Taro-Hayashi/Pop-n-Top/README.md

# Pop'n Top キーボード ビルドガイド（[English](https://github.com/Taro-Hayashi/Pop-n-Top/blob/main/README_EN.md)）
- [キット内容](#キット内容)
- [組み立て方（はんだ付け）](#組み立て方はんだ付け)
- [動作テスト](#動作テスト)
- [組み立て方（後半）](#組み立て方後半)
- [カスタマイズ](#キーマップの確認変更方法)
- [その他](#その他)

## キット内容
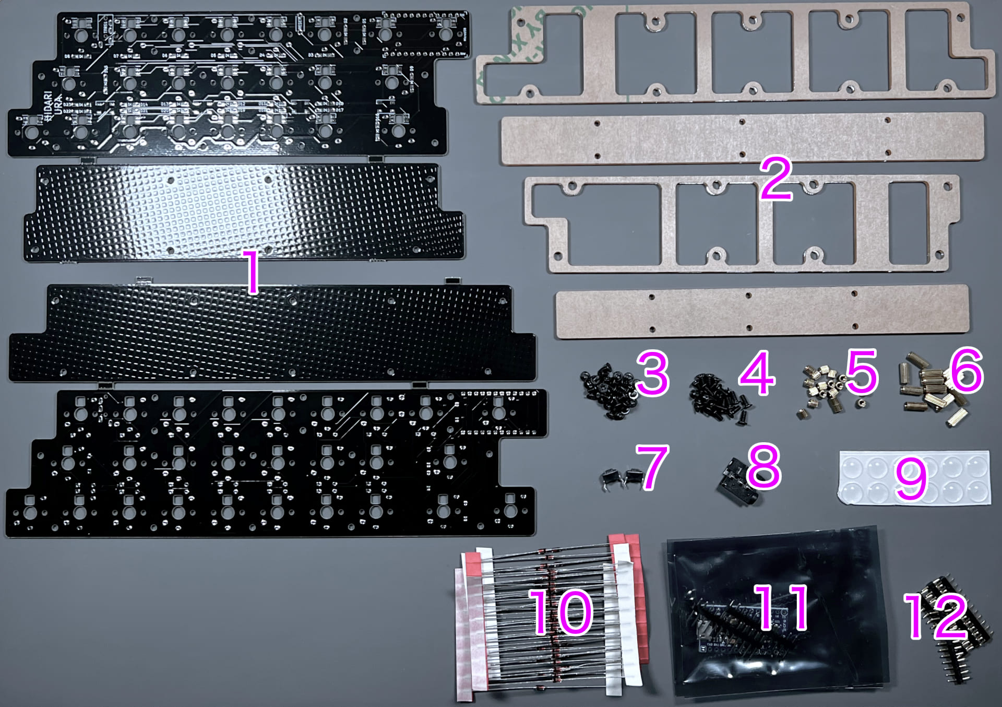
[picture p1: img/IMG_3636.jpg]
  
||部品名|数| |
|-|-|-|-|
|1|メインボード|2||
|1|アクリルプレート|4||
|3|ネジ（短）|36|3mm|
|4|ネジ（長）|24|5mm|
|5|スペーサー（短）|18|3mm|
|6|スペーサー（長）|12|9mm|
|7|リセットスイッチ|2||
|8|TRRSジャック|2||
|9|ゴム足|12||
|10|ダイオード|50||
|11|Pro Micro|2||
|12|コンスルー|4||

## キット以外に必要なもの

リンクにはアフィリエイトリンクを含みます。

|部品名|数||
|-|-|-|
|キースイッチ|50|[Kailh choc V1](https://shop.yushakobo.jp/collections/choc-v1)、Kailh Choc V2（[遊舎工房](https://shop.yushakobo.jp/collections/choc-v2)、[TALPKEYBOARD](https://shop.talpkeyboard.com/collections/keyswitch?ref=tarohayashi)）|
|キーキャップ|50|[選び方](howtochosekeycaps.md)|
|TRRSケーブル|1||
|Micro-USB ケーブル|1||
 - [Pro Micro互換品とコンスルーの対応表](promicro.md)  
 
### LED（[取り付け方](led.md)）
|部品名|数||
|-|-|-|
|[SK6812MINI-E](https://shop.yushakobo.jp/products/sk6812mini-e-10)|50|バックライト|
|[WS2812B](https://shop.yushakobo.jp/products/a0800ws-01-10)|9|アンダーグロー|

### Cintiq Pro用インチネジケース、机上用ケース
https://tarohayashi.booth.pm/items/3154435

## 必要な工具
|工具名|
|-|
|はんだごて|
|こて先クリーナー（こて台）|
|鉛入りはんだ|
|精密ドライバー|
|カッター|
|棒ヤスリ|
|ニッパー等ダイオードの足を切れるもの|
|Microsoft Edge、もしくはGoogle Chrome|

## 準備
メインボードはつながった状態で梱包されています。カッターナイフで軽く切れ込みを入れて曲げるように割ります。  
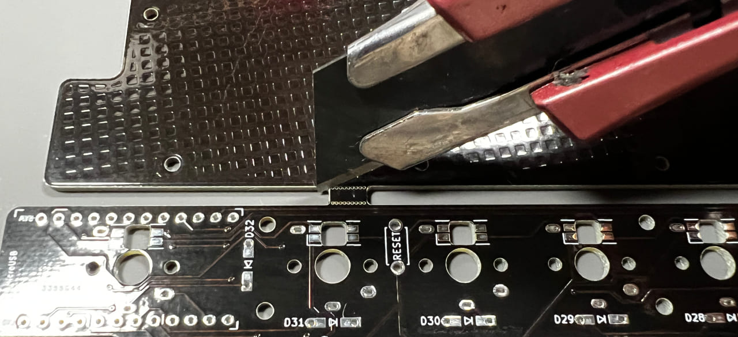
[picture p2: img/IMG_3646.jpg]
  
棒やすりで跡をきれいにします。  
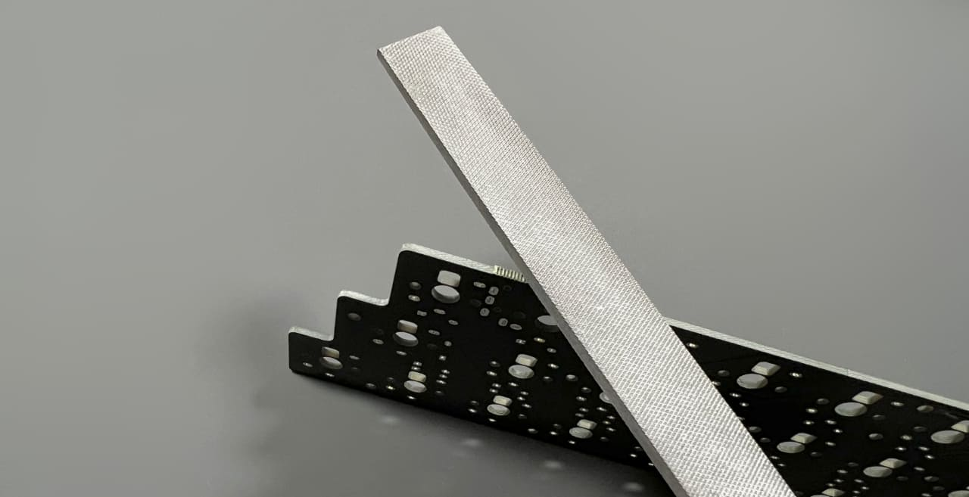
[picture p3: img/IMG_3655.jpg]
 
赤丸の箇所にやすりがけが必要です。
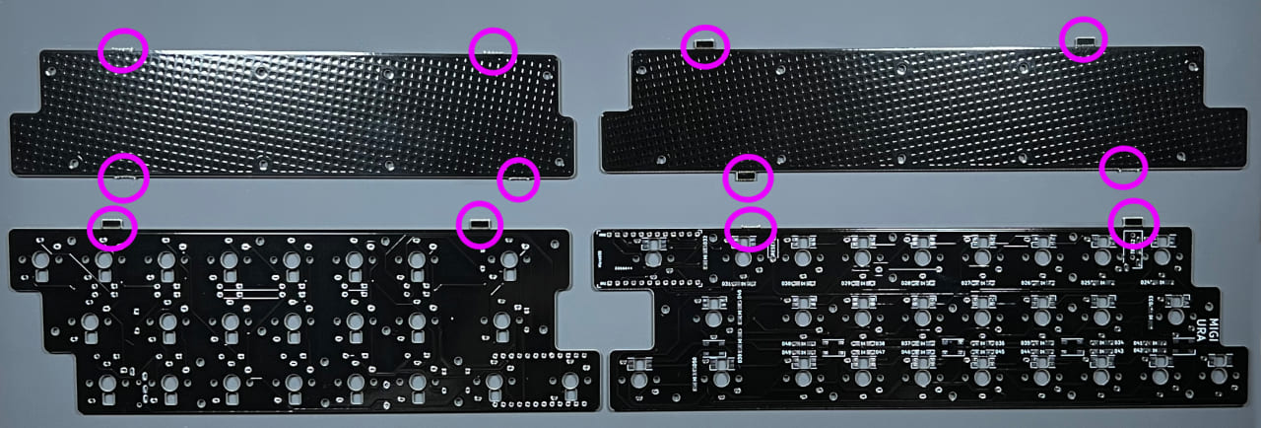
[picture p4: img/IMG_3649.jpg]
 

## 組み立て方（はんだ付け）

ダイオードを取り付けます。  
足を曲げて裏から差し込みます。  
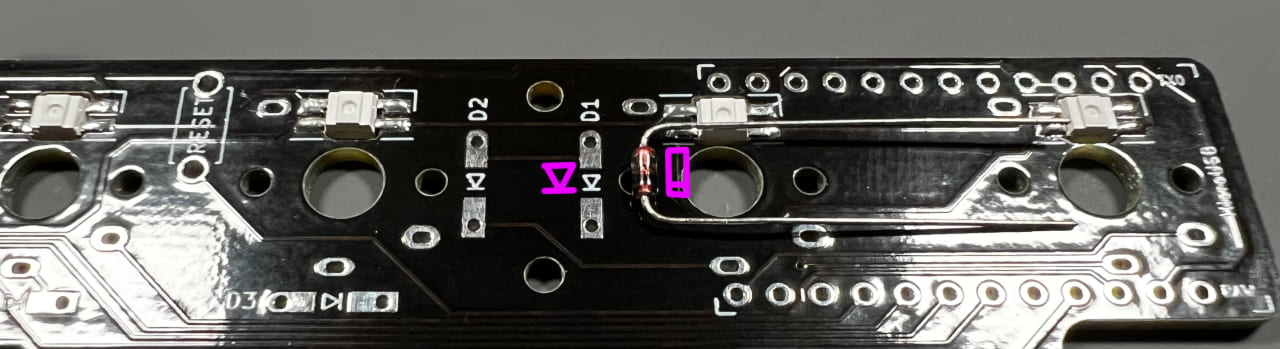
[picture p5: img/IMG_3668.jpg]
  
ダイオードには向きがあります。三角形の先の棒と黒線を合わせましょう。  

表で更に足を曲げて抜けないようにします。  
ダイオードと並行に曲げるとあとでキースイッチに干渉しにくいです。  
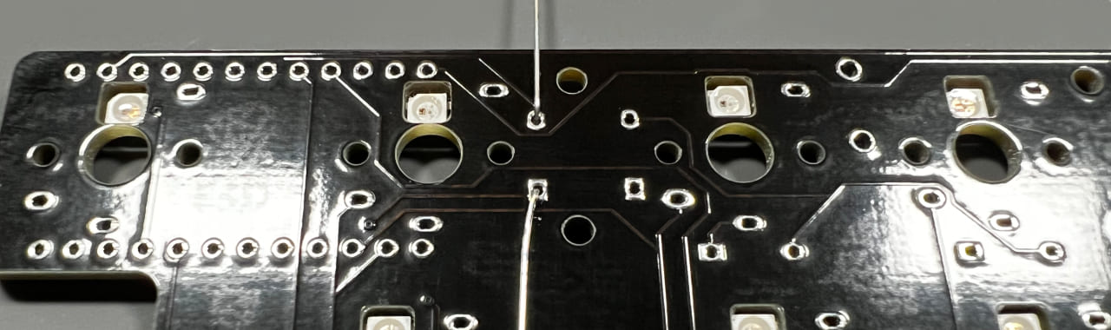
[picture p6: img/IMG_3678.jpg]
   

はんだ付けをして足を切ります。  
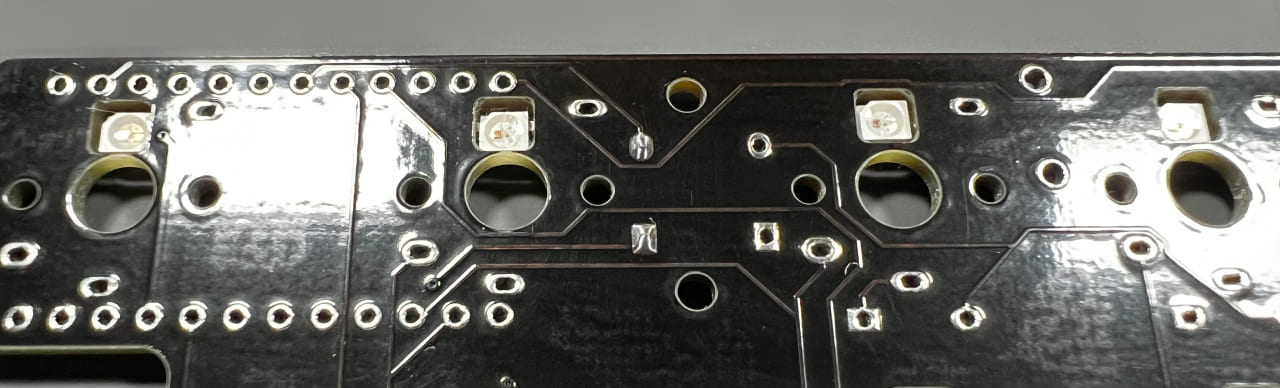
[picture p7: img/IMG_3680.jpg]
  

TRRSジャックを裏から差し込み表ではんだ付けします。 
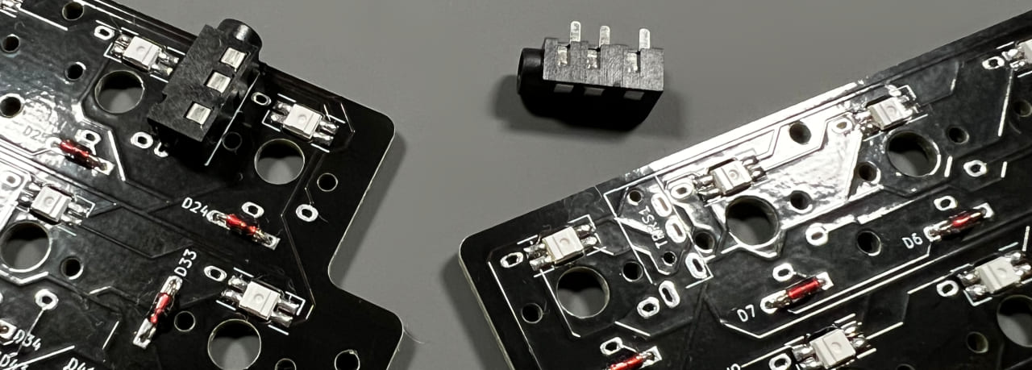
[picture p8: img/IMG_3685.jpg]
  
終わったらリセットスイッチを裏から差し込み表ではんだ付けします。   
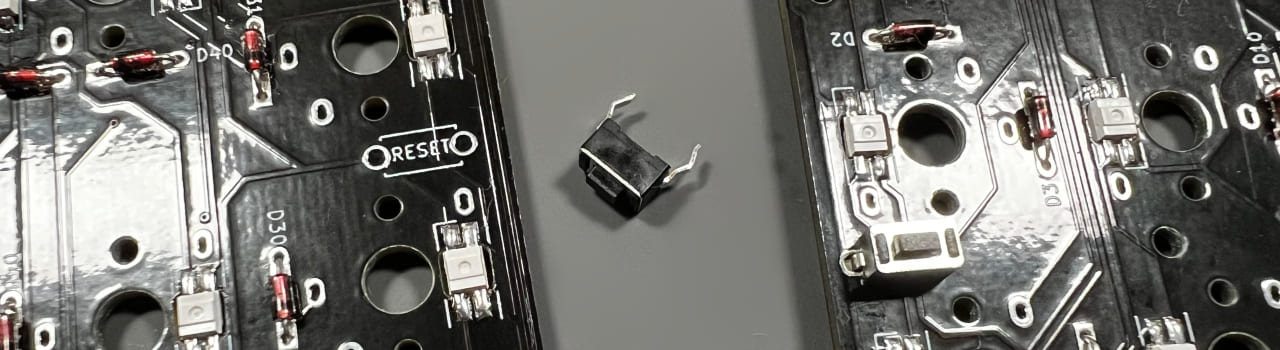
[picture p9: img/IMG_3688.jpg]
  

キースイッチを表から差し込み裏ではんだ付けします。  
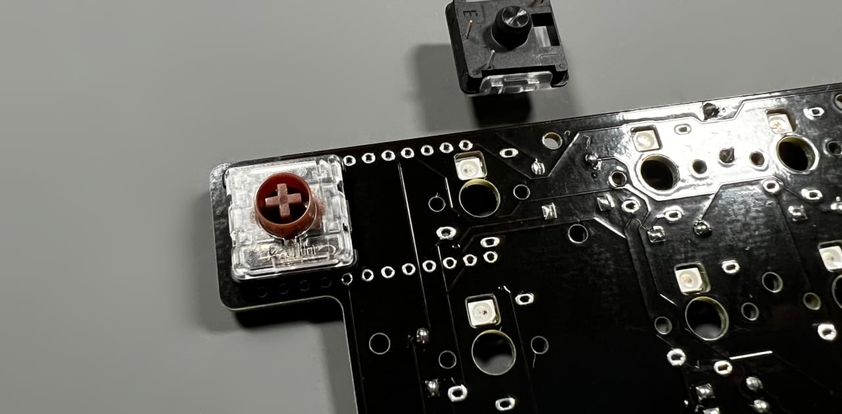
[picture p10: img/IMG_3699.jpg]
  

メインボードの裏にコンスルーを挿します。  
コンスルーの窓が高くて両方とも同じ向きになるように設置します。  
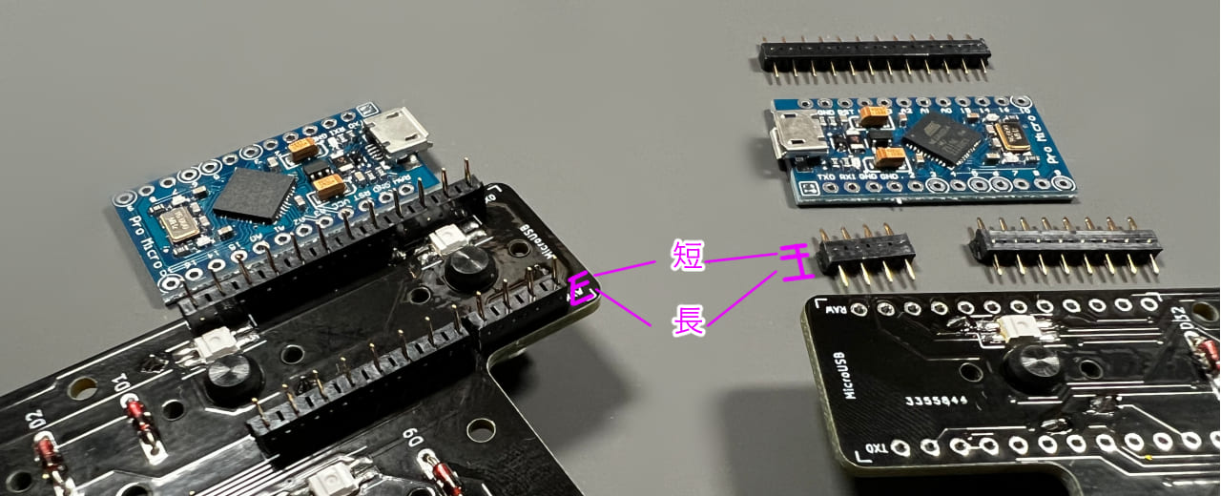
[picture p11: img/IMG_3706.jpg]
   
挿すだけではんだ付けはしません。  

コンスルーにPro Microを挿します。TX0, RAW, USBの位置をシルク印刷と合わせましょう。  
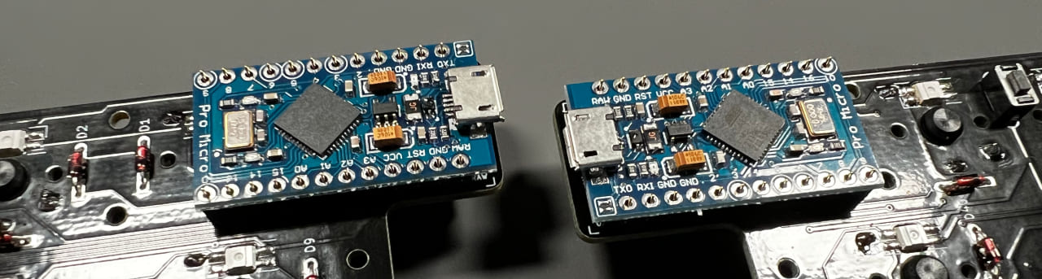
[picture p12: img/IMG_3721.jpg]
  
そして、Pro Micro側のコンスルーの足を半田付けします。  
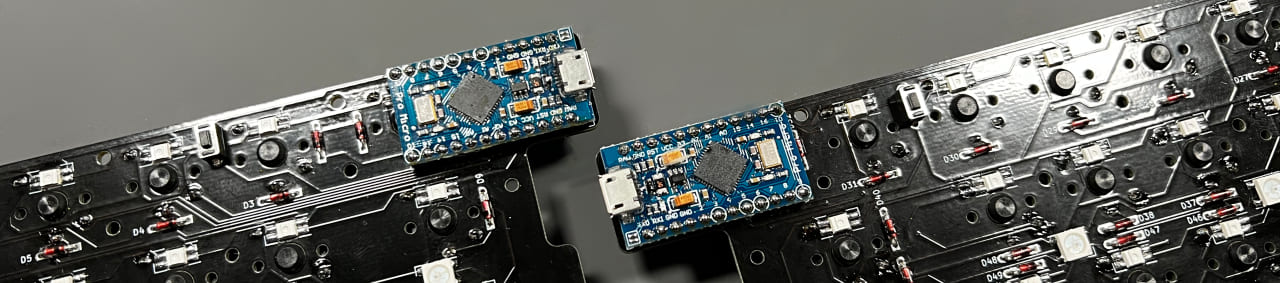
[picture p13: img/IMG_3727.jpg]
  
これでPro Microを抜き差しできるようになりました。  
両手分作り終えたら次に進んでください。  

## 動作テスト
Pro Microに動作ソフト（ファームウェア）を書き込んで動作確認をしましょう。  
キットとPCをUSBケーブルでつないでください。   

下のwebサイトにアクセスしてください。
- https://remap-keys.app/catalog/HJaX1fzuC9SmEQEK3czS/firmware

テストファームウェアを選んでFLASHします。
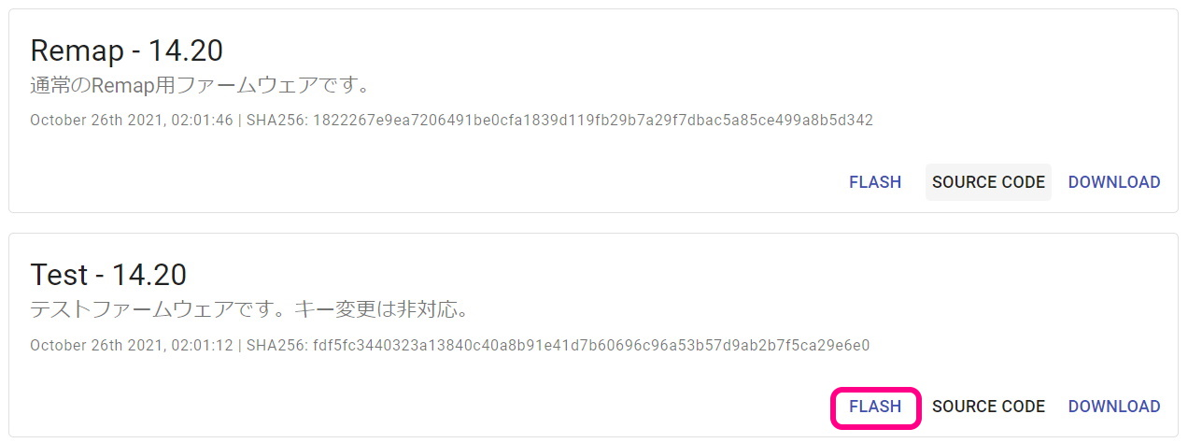
[picture p14: img/remap02.jpg]
  
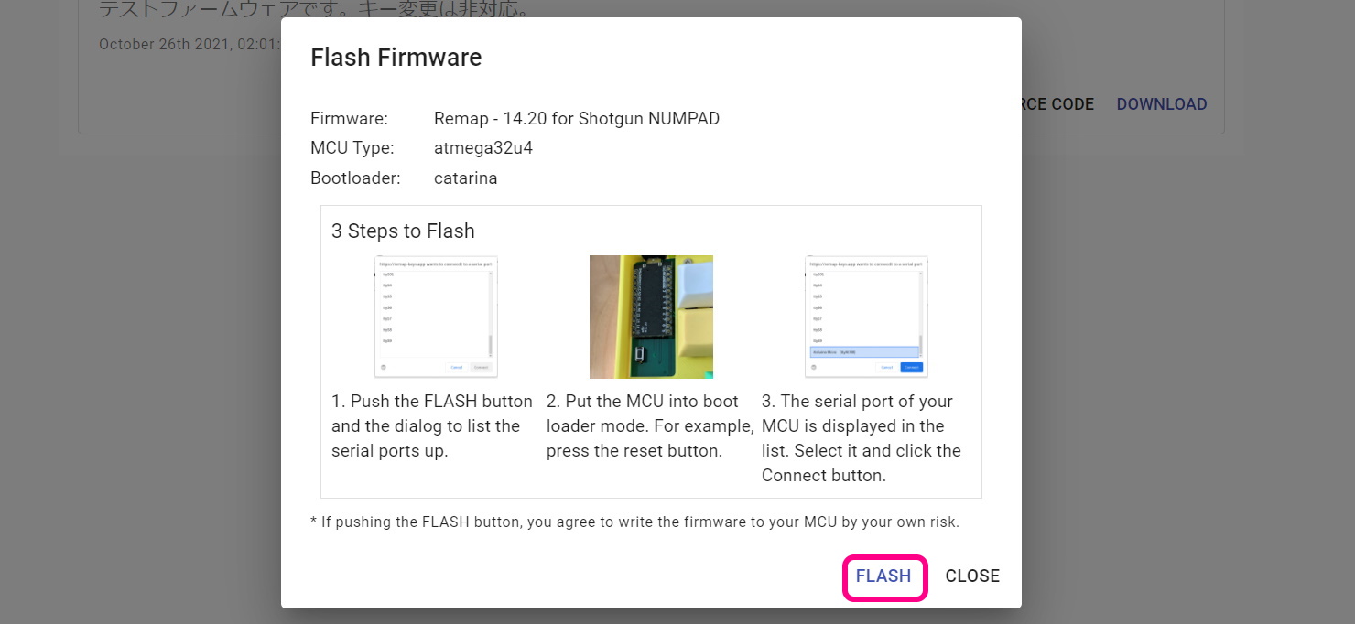
[picture p15: img/remap03.jpg]
  

キットのリセットスイッチを押すとArduino Microが現れるので、クリックして接続します。
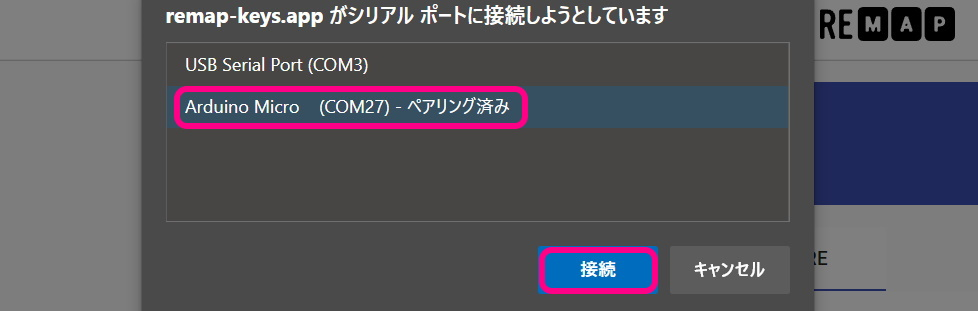
[picture p16: img/remap04.jpg]
 

書き込みが完了したらウィンドウを閉じて大丈夫です。
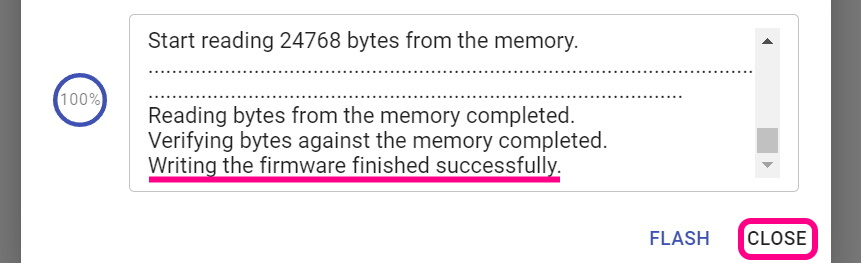
[picture p17: img/remap05.jpg]
 

USBで接続しないと書き込めないので分割キーボードでは左手用と右手用に同じ手順を繰り返します。  
右手用にも同じファームウェアを書き込んでください。  

書き込めたら一度USBケーブルを外し、TRRSケーブルで左右を繋げます。  
（TRRSケーブルを抜き差しするときはPCとは接続しない方が安全だそうです。）  
左手用とPCをUSBケーブルで接続してタイプすると1-50の数字が打てるはずです。     

お疲れ様でした。問題がなければはんだ付けは終了です。  

## 組み立て方（後半）
USBケーブル、TRRSケーブルを抜いてプレートを組付けます。  
アクリルからは保護フィルムを剥がしてください。割れやすいので気をつけましょう。  

メインボード裏面の赤丸の箇所にスペーサー（短）をネジ（短）で取り付けてミドルプレートを嵌めます。  
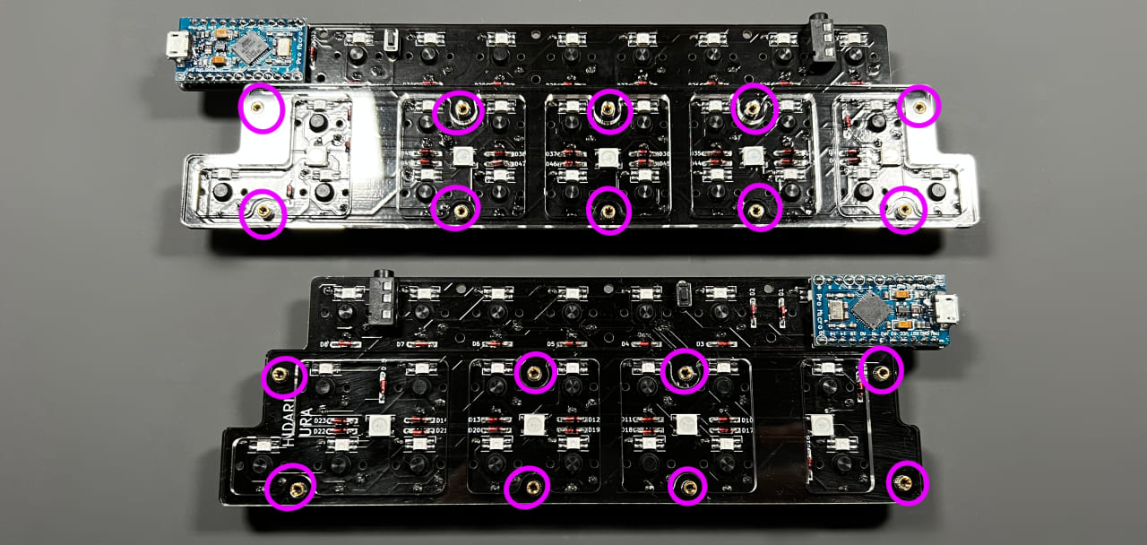
[picture p18: img/IMG_3736.jpg]
  
ボトムプレートをネジ（短）で止めます。  

メインボードの残ったネジ穴にスペーサー（長）をネジ（長）で取り付け、ボトムプレートをネジ（長）で止めます。  
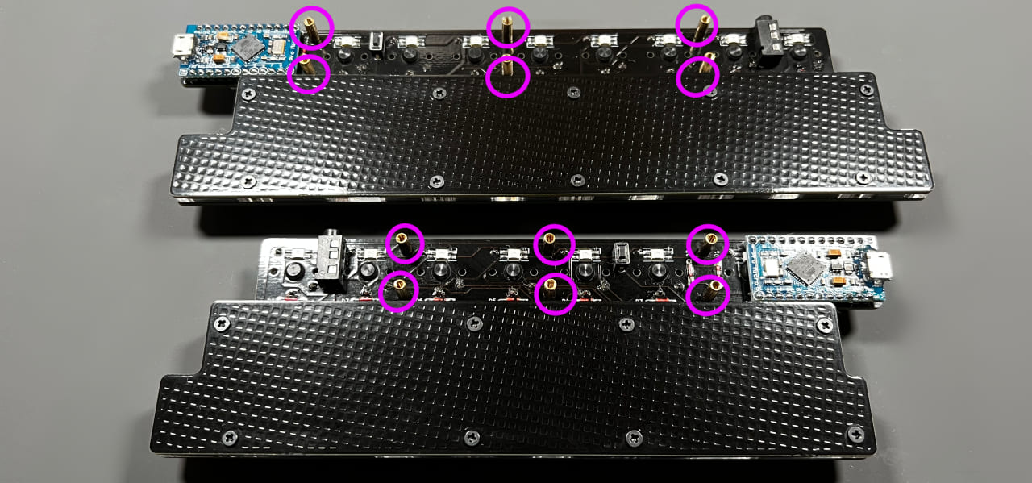
[picture p19: img/IMG_3741.jpg]
   

キーキャップを取り付けたら先ほどと同様の手順で本番用のファームウェアに更新しましょう。
- https://remap-keys.app/catalog/HJaX1fzuC9SmEQEK3czS/firmware
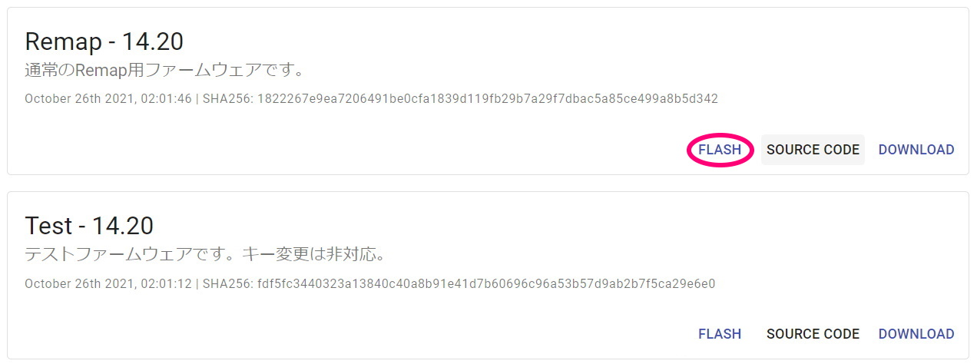
[picture p20: img/remap06.jpg]
  

ゴム足を貼ってTRRSケーブルで左右を繋いだら完成です。  
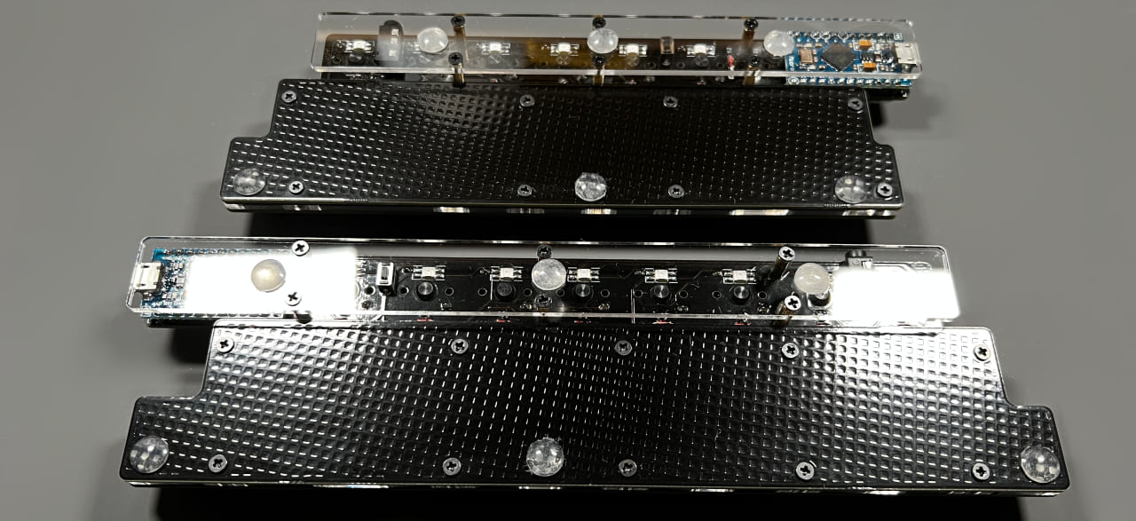
[picture p21: img/IMG_3748.jpg]
  
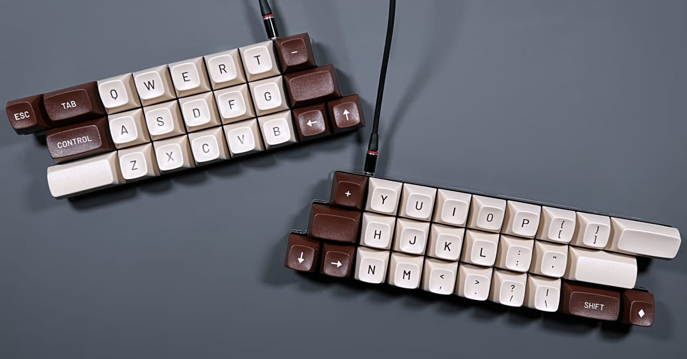
[picture p22: img/IMG_3757.jpg]
  
USBケーブルは左手用に接続してください。  

## キーマップの確認、変更方法
このキットはレイヤー機能を使っています。  
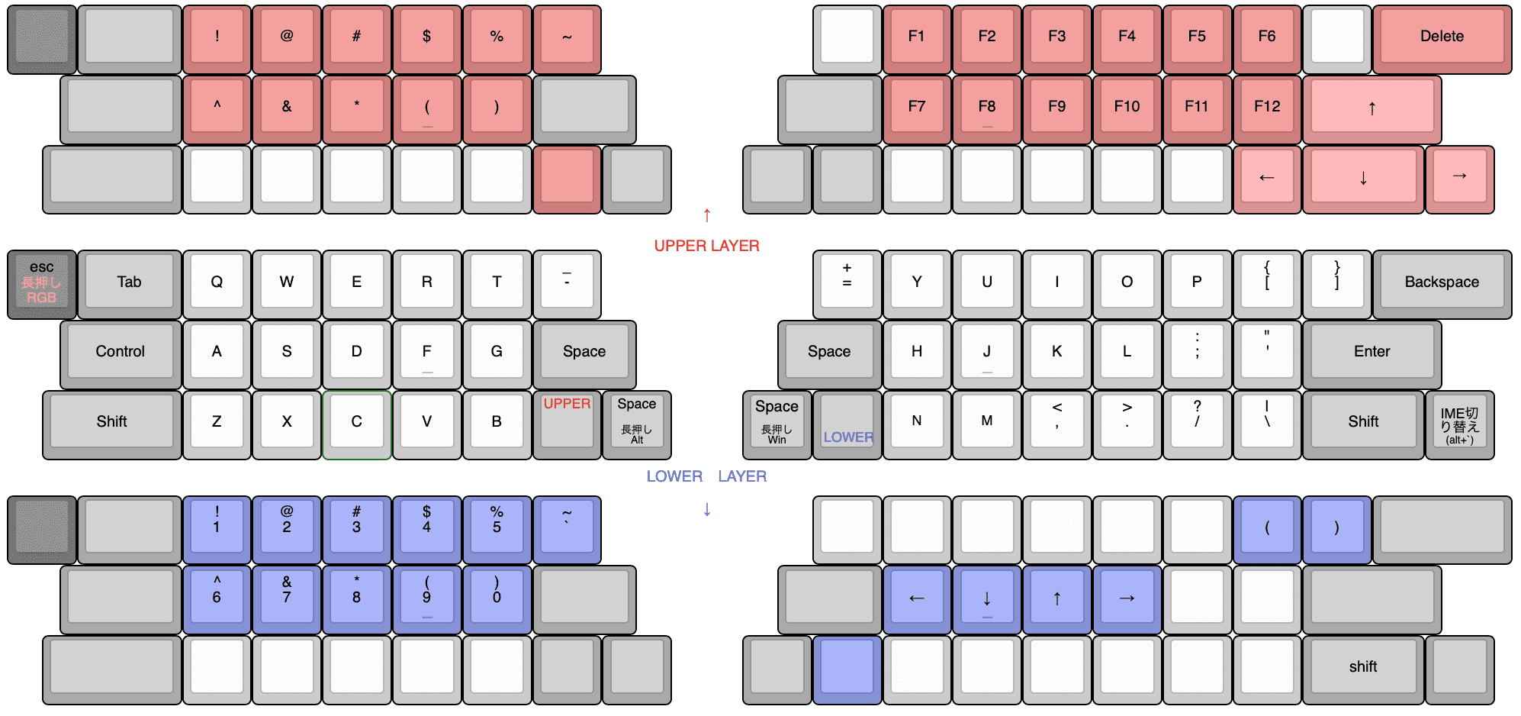
[picture p23: img/layout.png]

[Keyboard Layout Editor で見る](http://www.keyboard-layout-editor.com/#/gists/a78d9342dd93a60fed1b255a5a018bf9)  

使わないキーを削除したり使用頻度の高いキーを押しやすい位置に変更してみましょう。  

  ChromeかEdgeでRemapにアクセスしてください。  
- Remap https://remap-keys.app

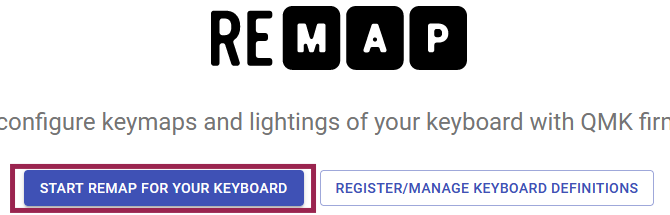
[picture p24: img/remap1.png]
  
左を選んで進んでいくとアドレスバーからメッセージが出てキーボードを選択できます。

キーマップをドラッグアンドドロップで変更し右上のflashボタンを押すと反映されます。  
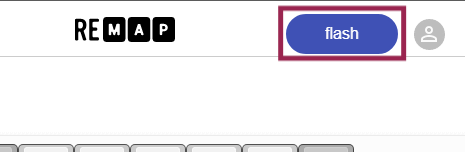
[picture p25: img/remap3.png]
  

## その他
### 液晶タブレットに乗せる
1番上の行を引っ掛ける事で液タブに乗せる事ができます。  
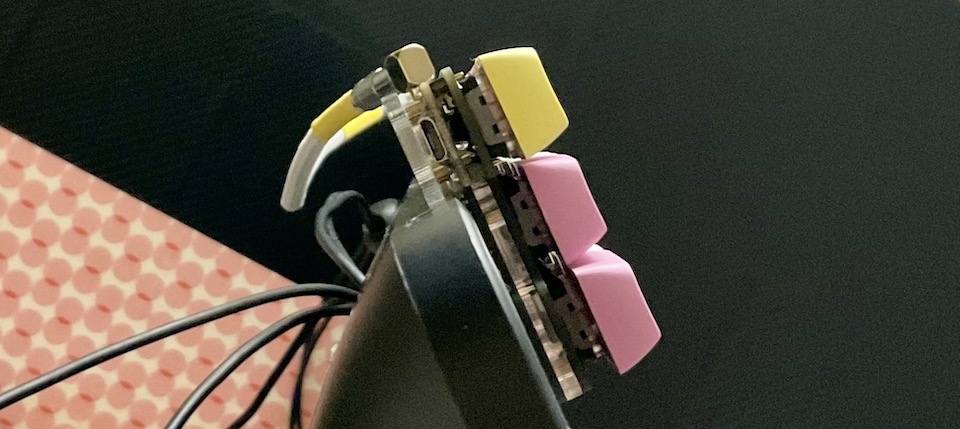
[picture p26: img/tab.jpeg]
  
ゴム足を外して両面テープで固定すると安定します。  
跡が残るといけないので画面には保護フィルムを貼ってください。  
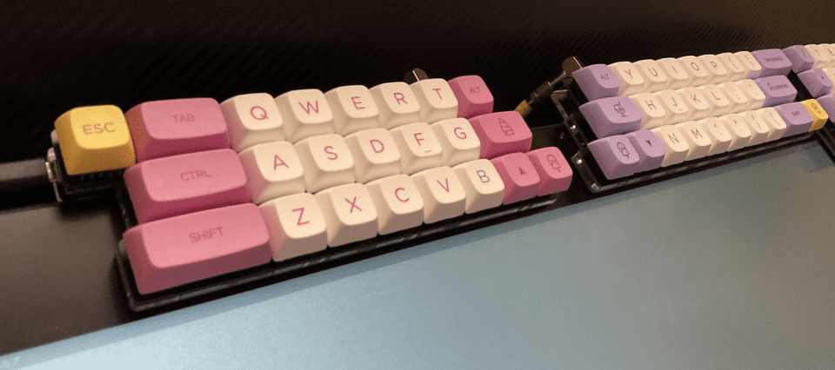
[picture p27: img/popntop.png]


### 色違いアクリルプレート
遊舎工房さんで注文可能です。  
- https://shop.yushakobo.jp/collections/services/products/keyboard_acrylic_plate?variant=43890222498023  
  
デザインデータを公開しているのでご自分で発注をかけることも可能です。  
- [popntop_plates.zip](https://github.com/Taro-Hayashi/Pop-n-Top/releases/download/14.20/popntop_plates.zip)  
  
### ファームウェアのフォルダ  
- [qmk_firmware](qmk_firmware)
  
### 謝辞
foostan様のフットプリントを流用、改変して使わせていただきました。  
https://github.com/foostan/kbd/  
https://github.com/foostan/kbd/blob/master/LICENSE  

- 遊舎工房: https://shop.yushakobo.jp/products/2796  
- BOOTH: https://tarohayashi.booth.pm/items/3154435
