Taro-Hayashi/Pop-n-Top/case.md

# Pop'n Top Cintiq Pro用インチネジケース、机上用ケースの取り付け方

## Cintiq Pro用インチネジケース

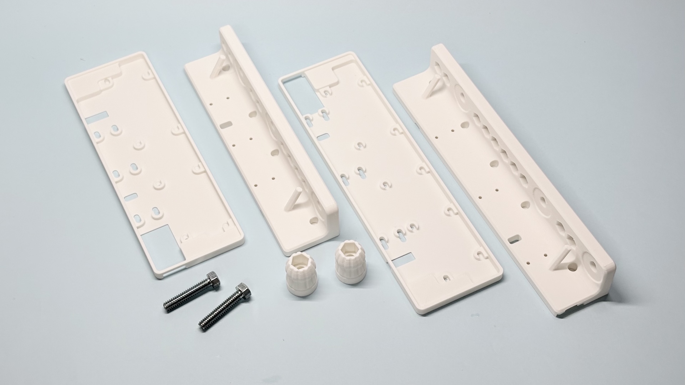
[picture p28: img/case/IMG_4292.jpg]

キーボード背面のネジを全て外してアクリルプレート、ボトムプレートを外します。
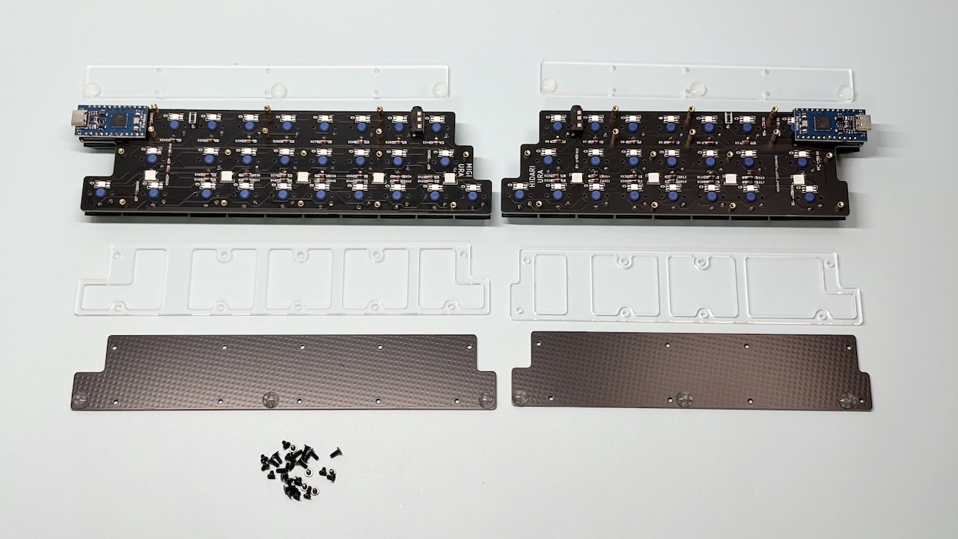
[picture p29: img/case/IMG_4127.jpg]

メインボードをケースに収めます。
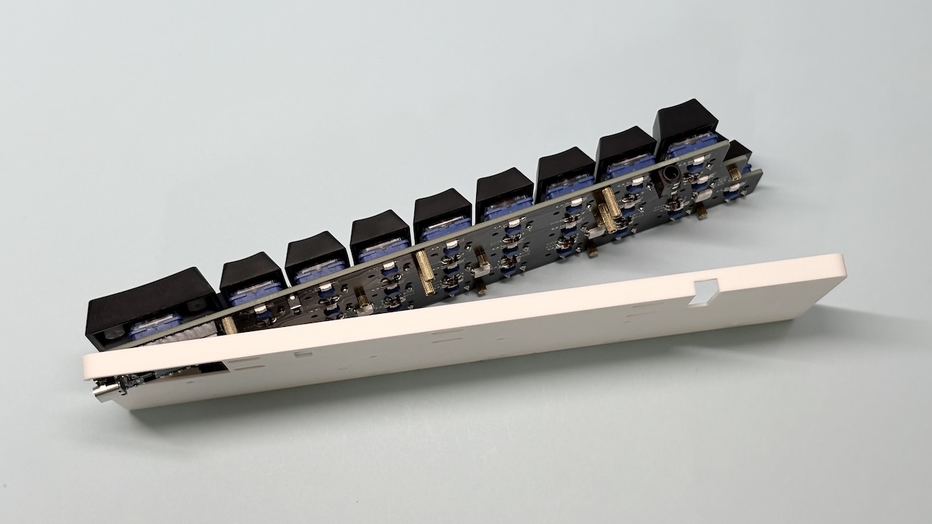
[picture p30: img/case/IMG_4151.jpg]

もとのネジでケースを取り付けます。
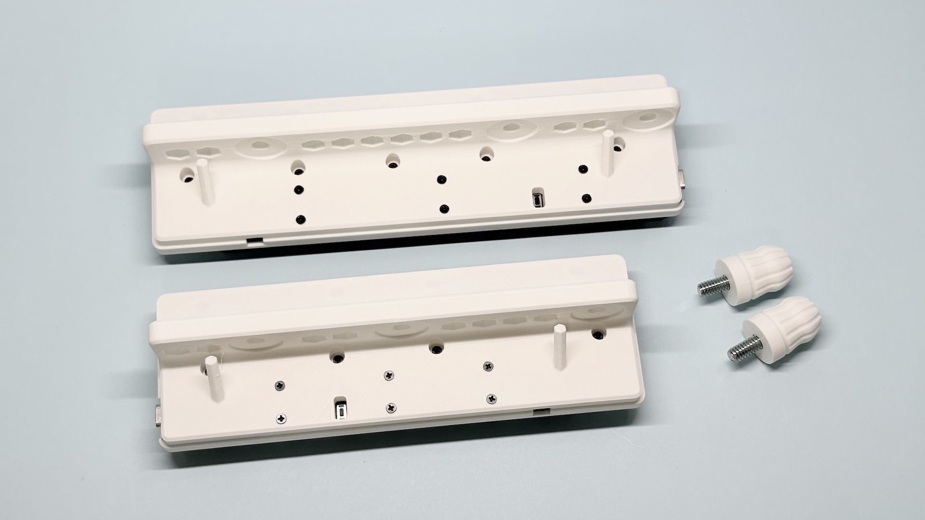
[picture p31: img/case/IMG_4301.jpg]

Cintiq Proに固定します。
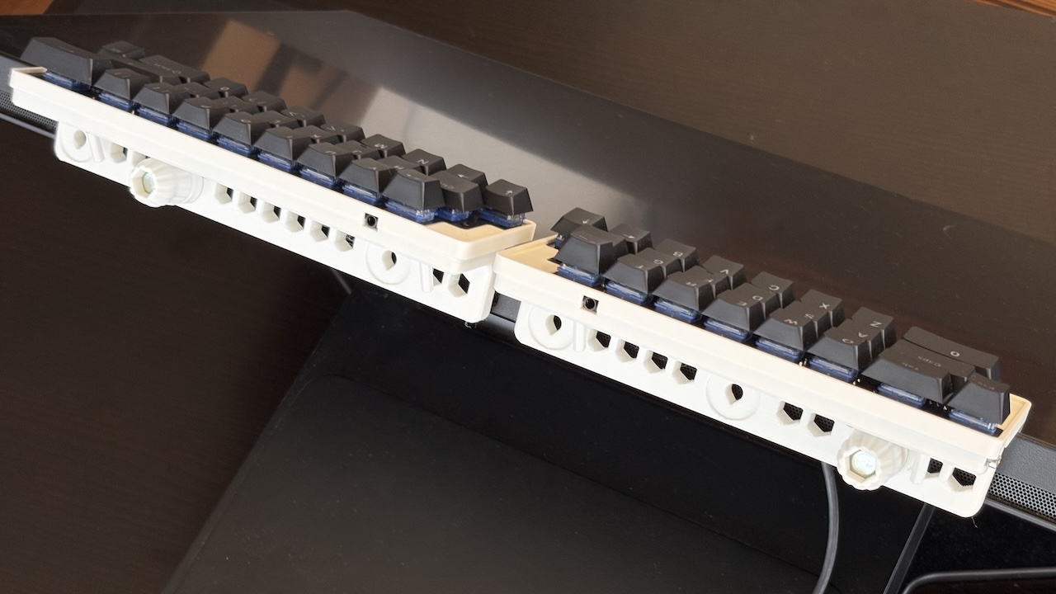
[picture p32: img/case/IMG_4310.jpg]

片手につき3種類取り付け場所があります（Cintiq Pro 22では左右が重なって使えないパターンがあります）。
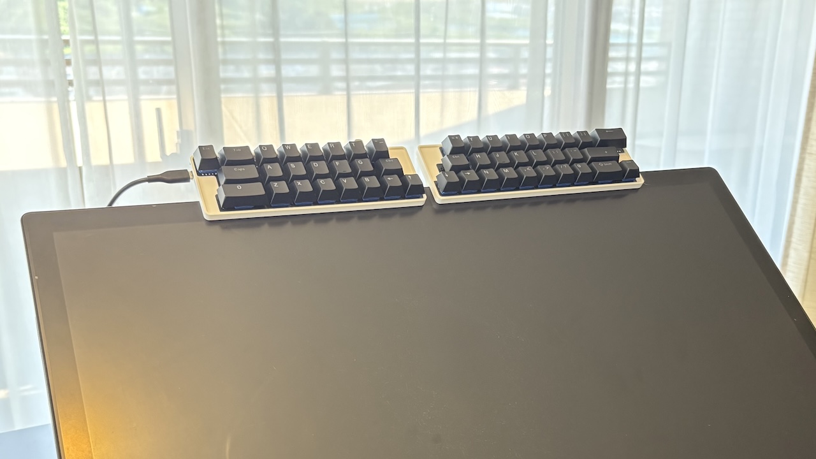
[picture p33: img/case/IMG_4315.jpg]


## 机上用ケース

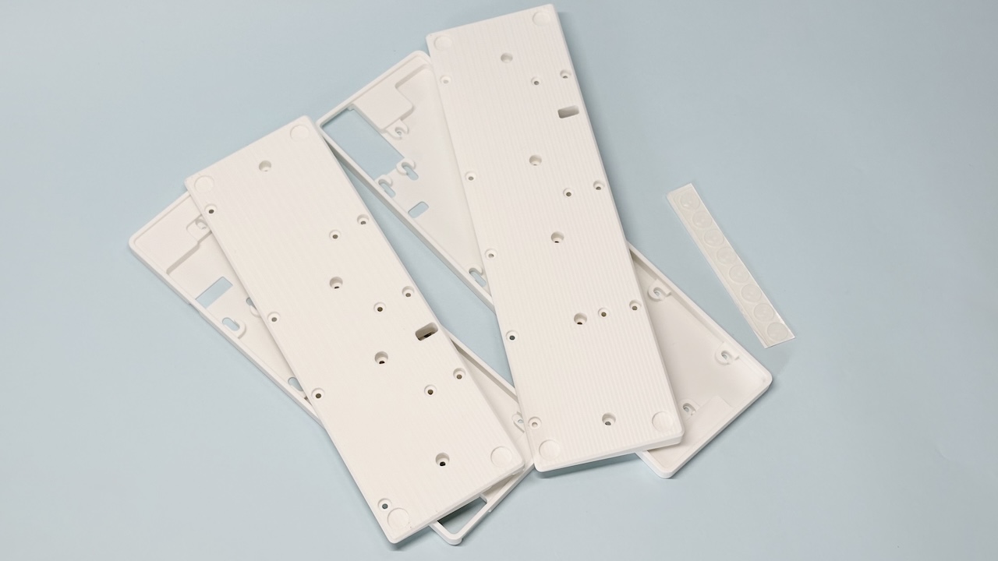
[picture p34: img/case/IMG_4114.jpg]

キーボード背面のネジを全て外してアクリルプレート、ボトムプレートを外します。

メインボードをケースに収めます。

もとのネジでケースを取り付けてゴム足を付けます。
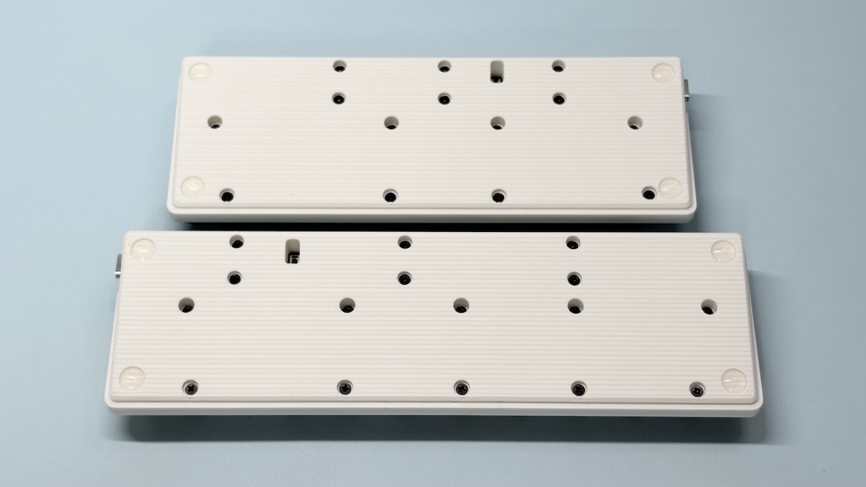
[picture p35: img/case/IMG_4169.jpg]

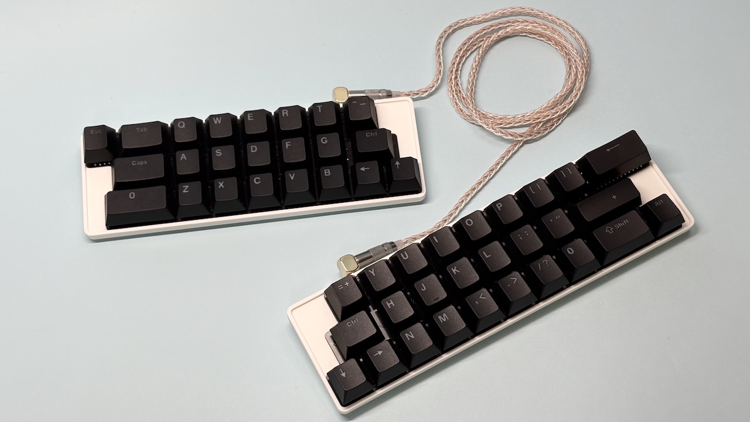
[picture p36: img/case/IMG_4177.jpg]
