Taro-Hayashi/Pop-n-Top/qmk_firmware/keyboards/popntop/README.MD

# Pop'n Top キーボード
- Manual: https://github.com/Taro-Hayashi/Pop-n-Top/blob/main/README_EN.md
- BOOTH: https://tarohayashi.booth.pm/items/3154435
- Yushakobo: https://shop.yushakobo.jp/en/products/2796
