Taro-Hayashi/Pop-n-Top/promicro.md

# Pro Micro互換品とコンスルーの対応表

||付属ピンヘッダ|[2.5mmコンスルー](https://shop.yushakobo.jp/products/31?variant=37665714405537)|[3.5mmコンスルー](https://talpkeyboard.net/items/6229e8c130344b271f290c3c)|
|-|-|-|-|
|Pro Micro|○|○|○|
|Type-C版Pro Micro|○|○|×|
|Elite-C|○|○|○|
