Taro-Hayashi/Pop-n-Top/img/case/IMG_4162.jpg

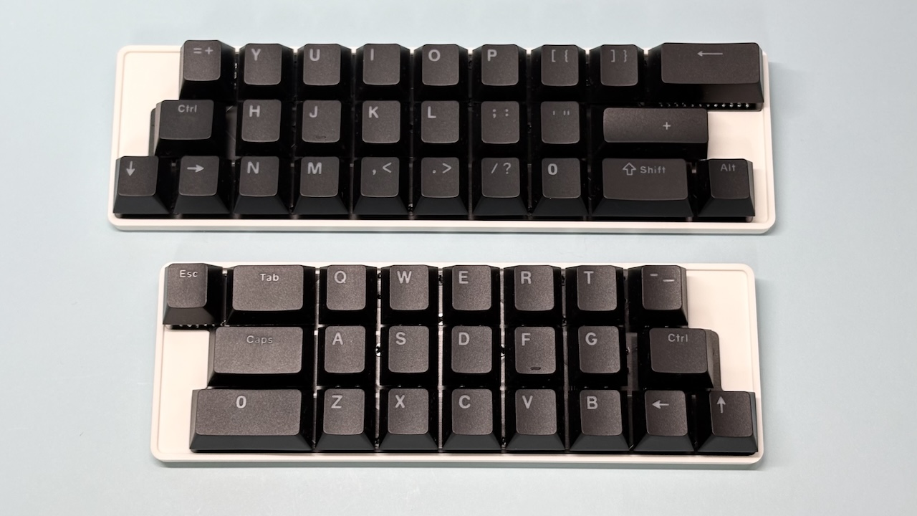
img/case/IMG_4162.jpg
