Taro-Hayashi/Pop-n-Top/img/case/IMG_4438.jpg

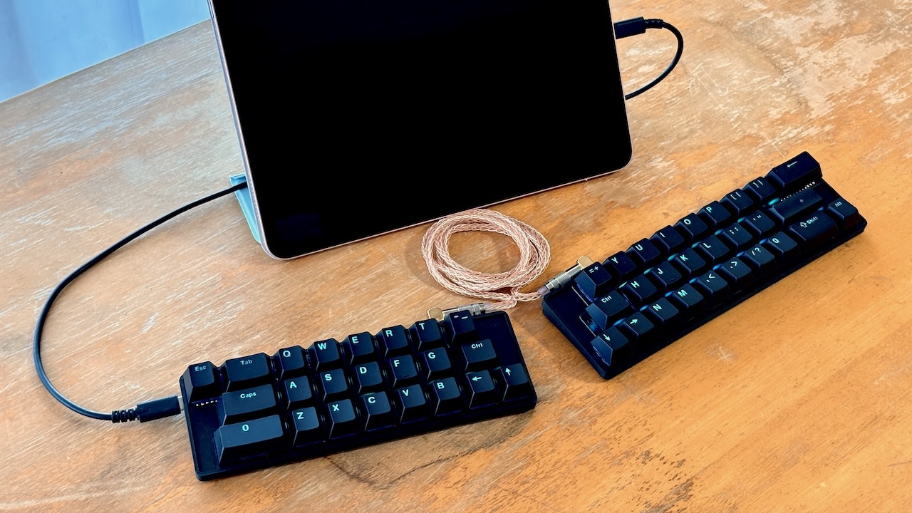
img/case/IMG_4438.jpg
