Taro-Hayashi/Pop-n-Top/img/case/IMG_4446.jpg

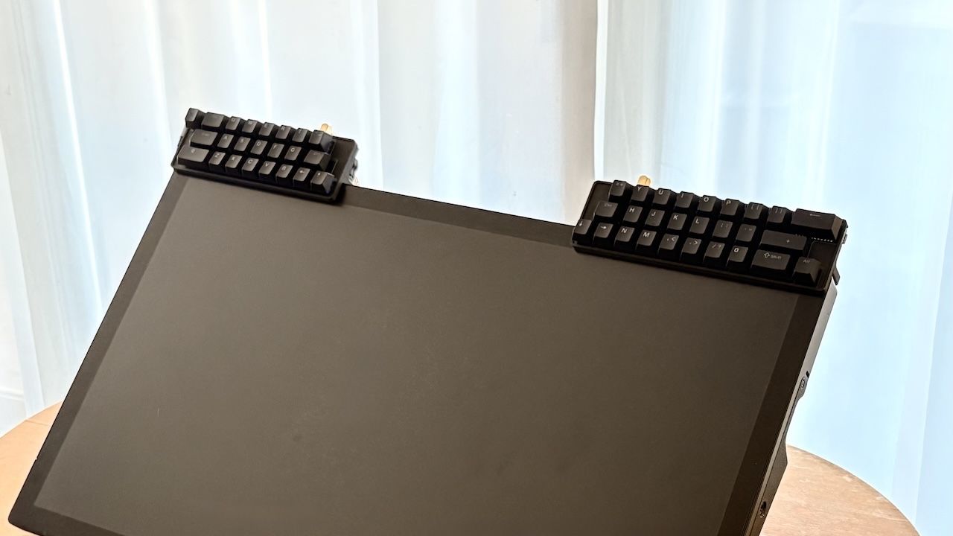
img/case/IMG_4446.jpg
