Taro-Hayashi/Pop-n-Top/img/diode1.jpg

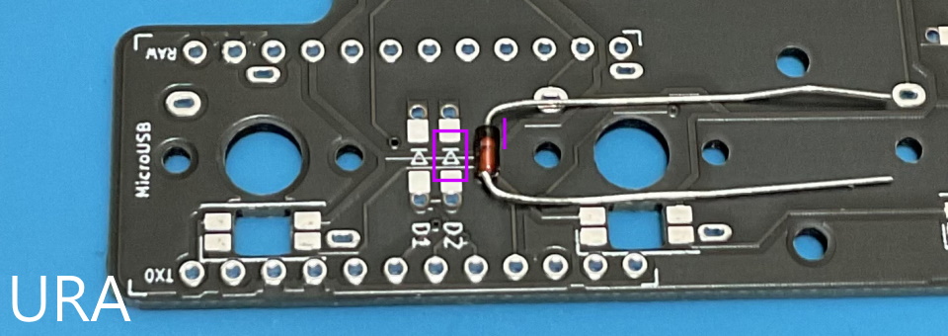
img/diode1.jpg
