Taro-Hayashi/Pop-n-Top/img/diode5.jpg

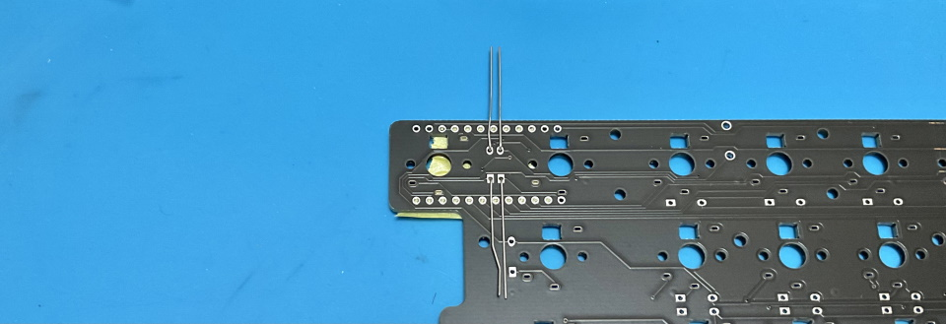
img/diode5.jpg
