Taro-Hayashi/Pop-n-Top/img/diode6.jpg

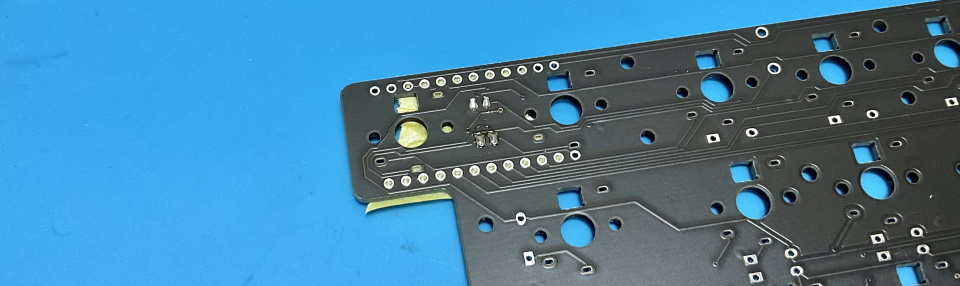
img/diode6.jpg
