Taro-Hayashi/Pop-n-Top/img/full2.jpg

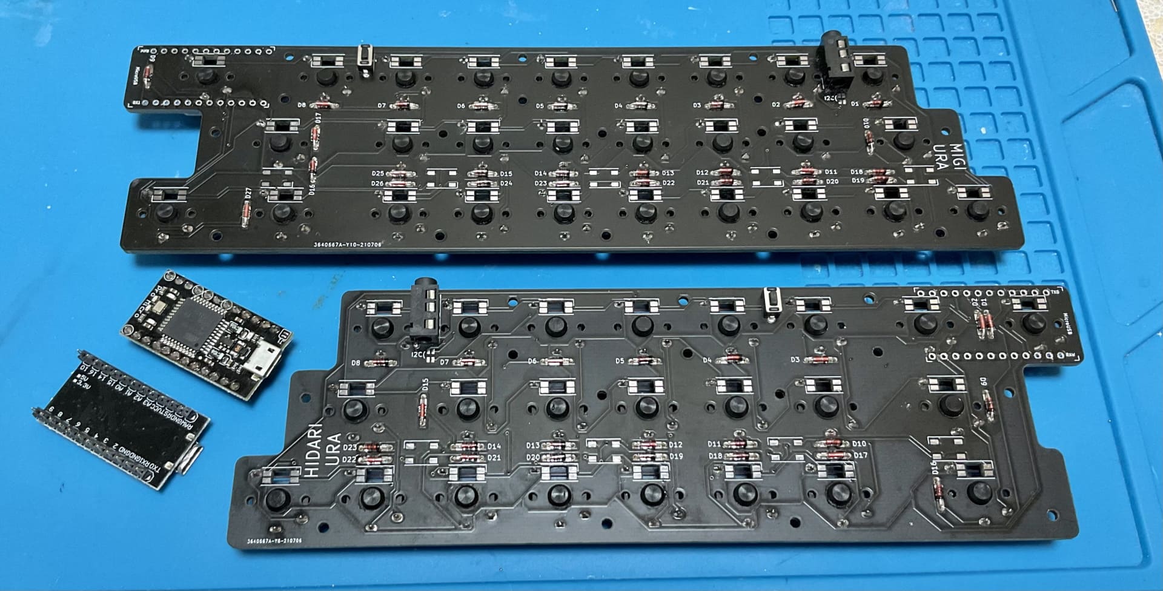
img/full2.jpg
