Taro-Hayashi/Pop-n-Top/img/IMG_4966.jpg

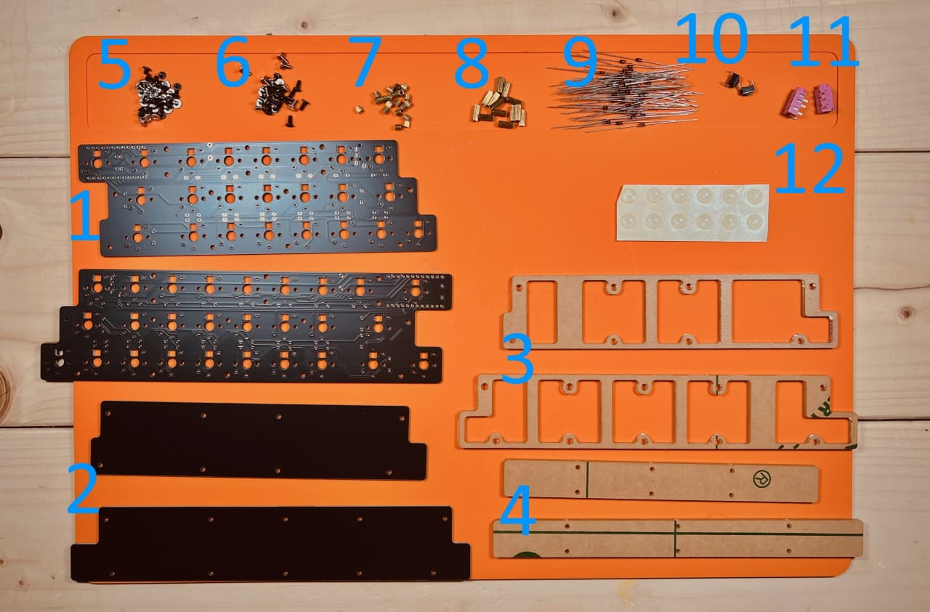
img/IMG_4966.jpg
