Taro-Hayashi/Pop-n-Top/img/IMG_5047.jpg

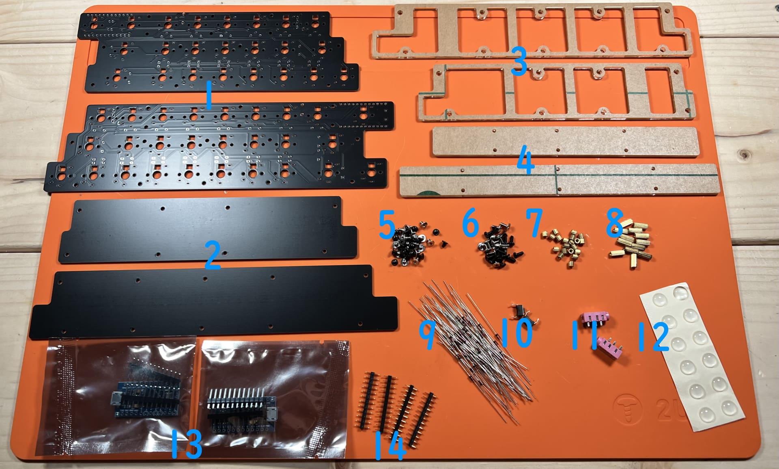
img/IMG_5047.jpg
