Taro-Hayashi/Pop-n-Top/img/IMG_9501.jpeg

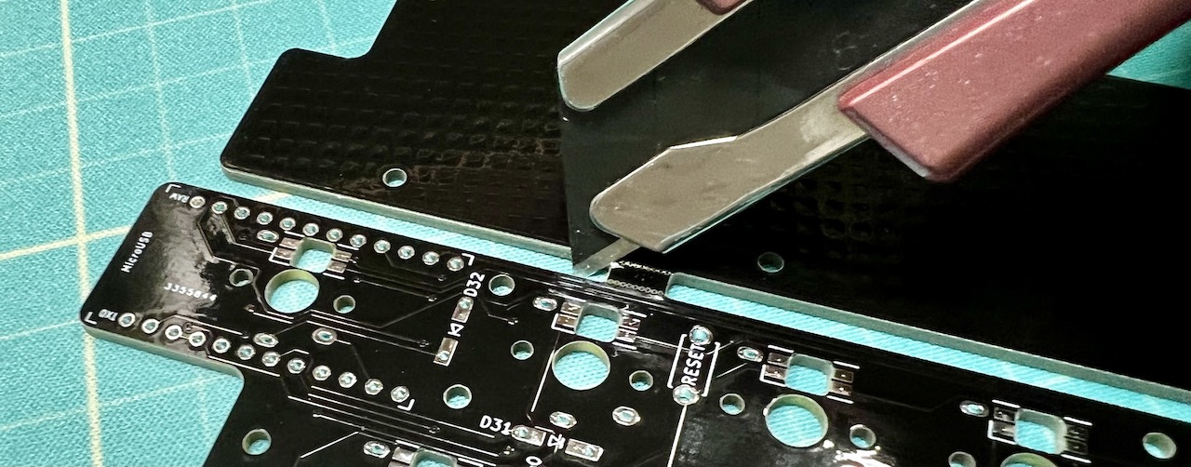
img/IMG_9501.jpeg
