Taro-Hayashi/Pop-n-Top/img/IMG_9507.jpeg

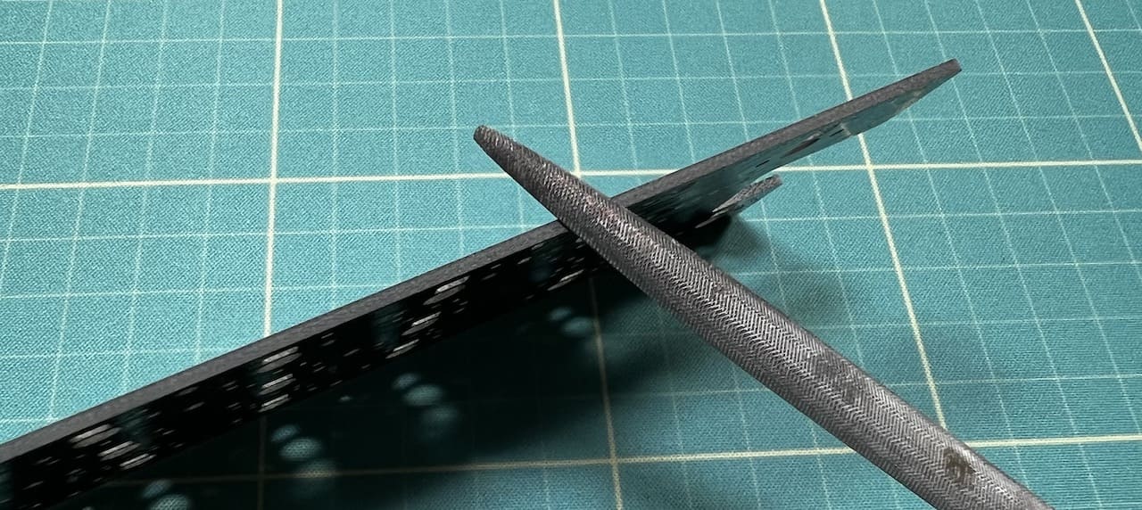
img/IMG_9507.jpeg
