Taro-Hayashi/Pop-n-Top/img/led1.jpeg

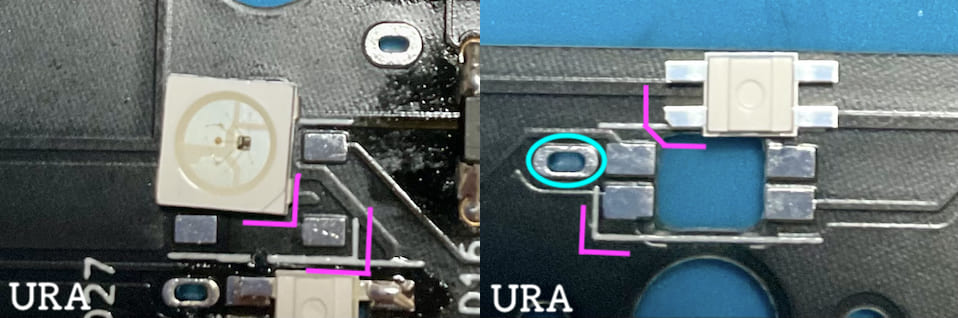
img/led1.jpeg
