Taro-Hayashi/Pop-n-Top/img/promicro1.jpg

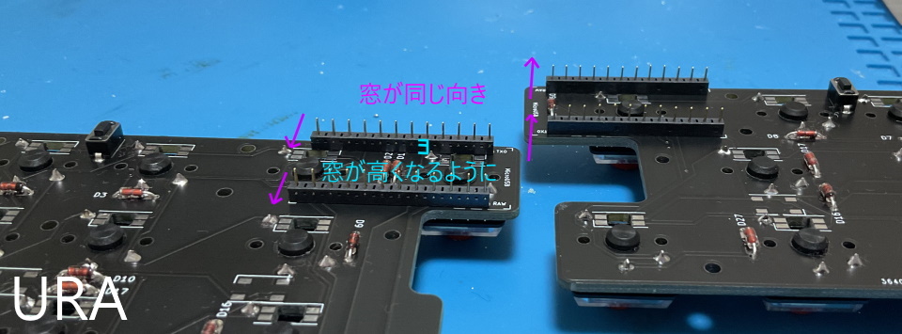
img/promicro1.jpg
