Taro-Hayashi/Pop-n-Top/img/promicro2.jpg

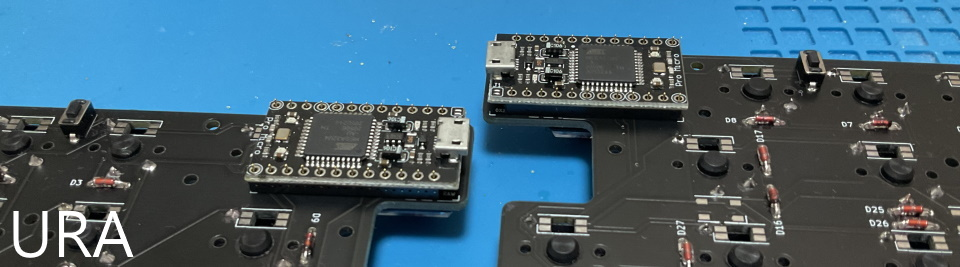
img/promicro2.jpg
