Taro-Hayashi/Pop-n-Top/img/promicro4.jpg

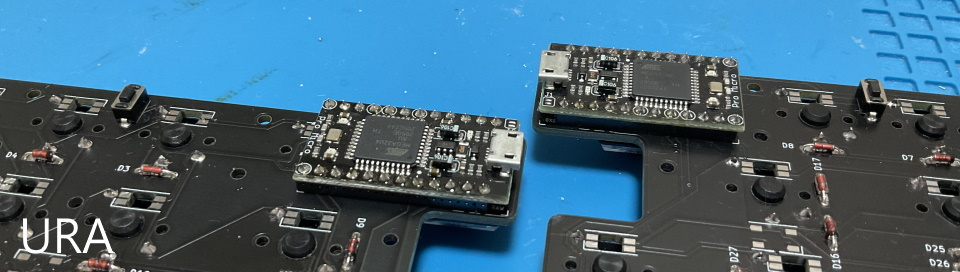
img/promicro4.jpg
