Taro-Hayashi/Pop-n-Top/img/rubber.jpg

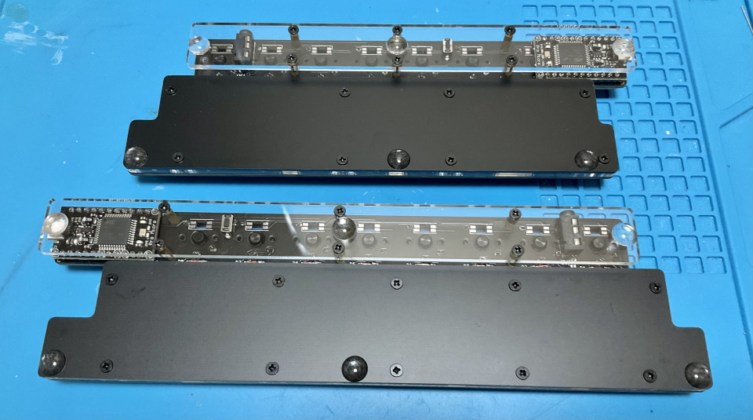
img/rubber.jpg
