Taro-Hayashi/Pop-n-Top/img/set.jpg

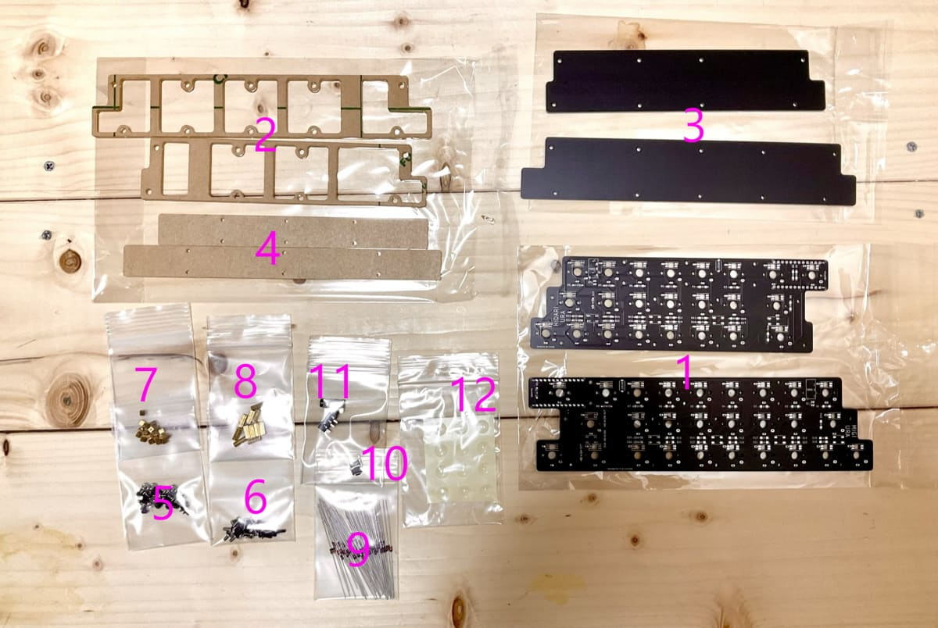
img/set.jpg
