Taro-Hayashi/Pop-n-Top/img/size.png

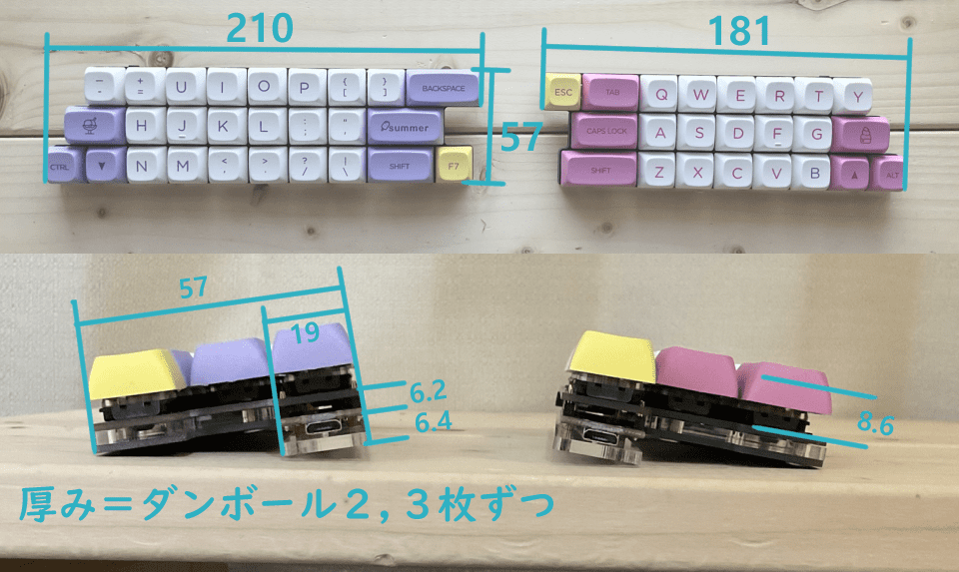
img/size.png
