Taro-Hayashi/Pop-n-Top/img/switch.jpg

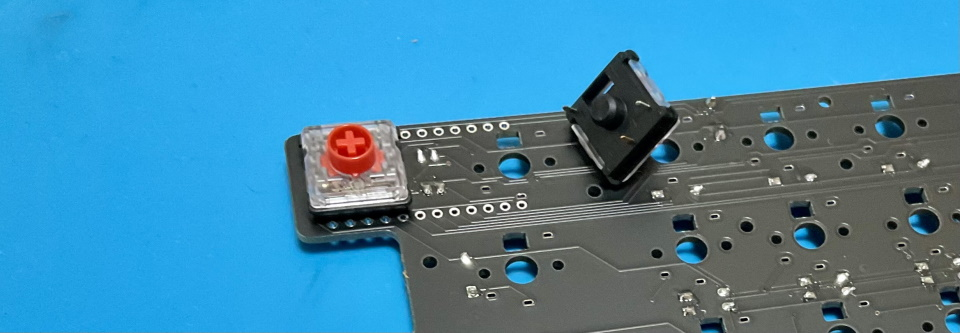
img/switch.jpg
