Taro-Hayashi/Pop-n-Top/img/trrs2.jpg

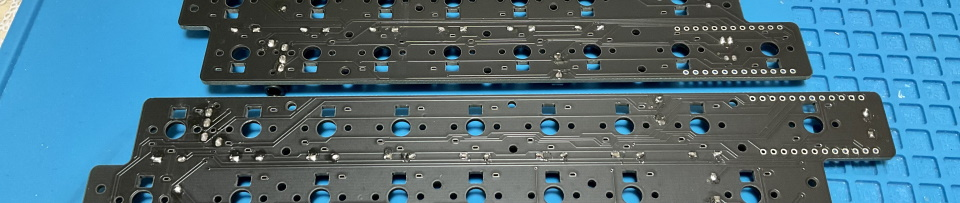
img/trrs2.jpg
