Taro-Hayashi/Pop-n-Top/img/trrs.jpg

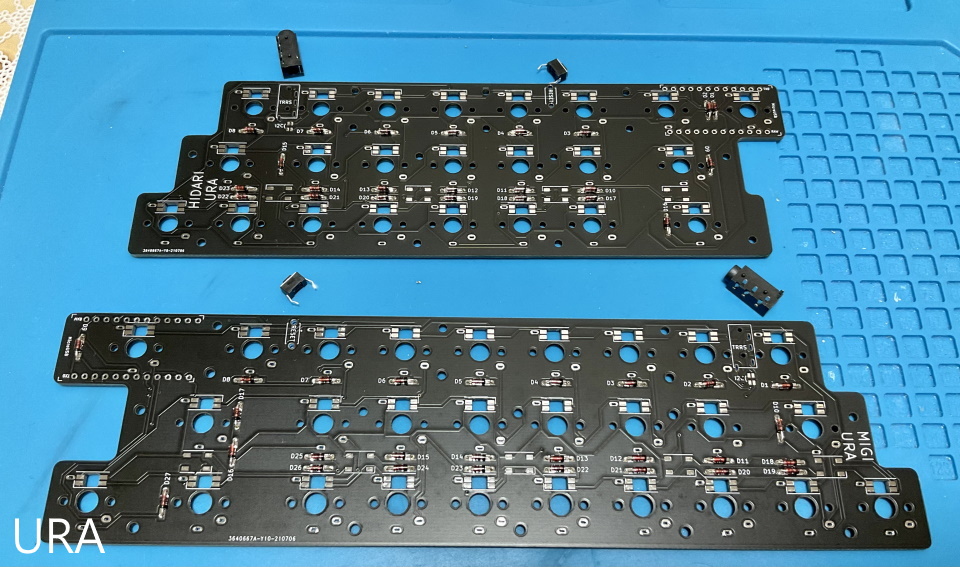
img/trrs.jpg
