Taro-Hayashi/Pop-n-Top/img/via1.png

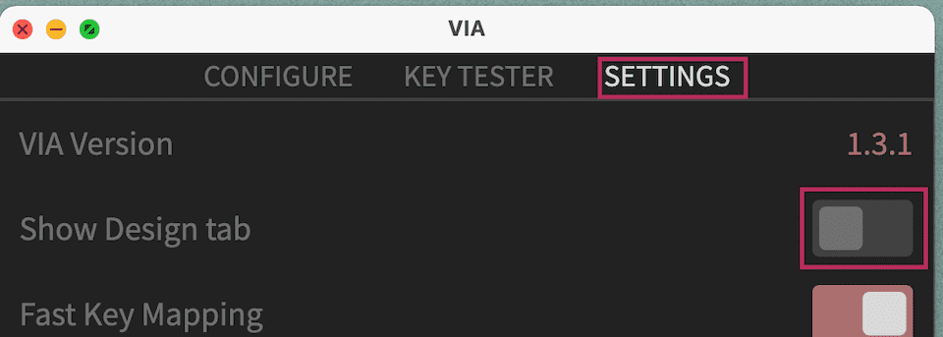
img/via1.png
