Taro-Hayashi/Pop-n-Top/preassembled.md

# Pop'n Top キーボード 取り扱い説明書

## 内容品
- Pop'n Topキーボード 1個
- TRRSケーブル 1本

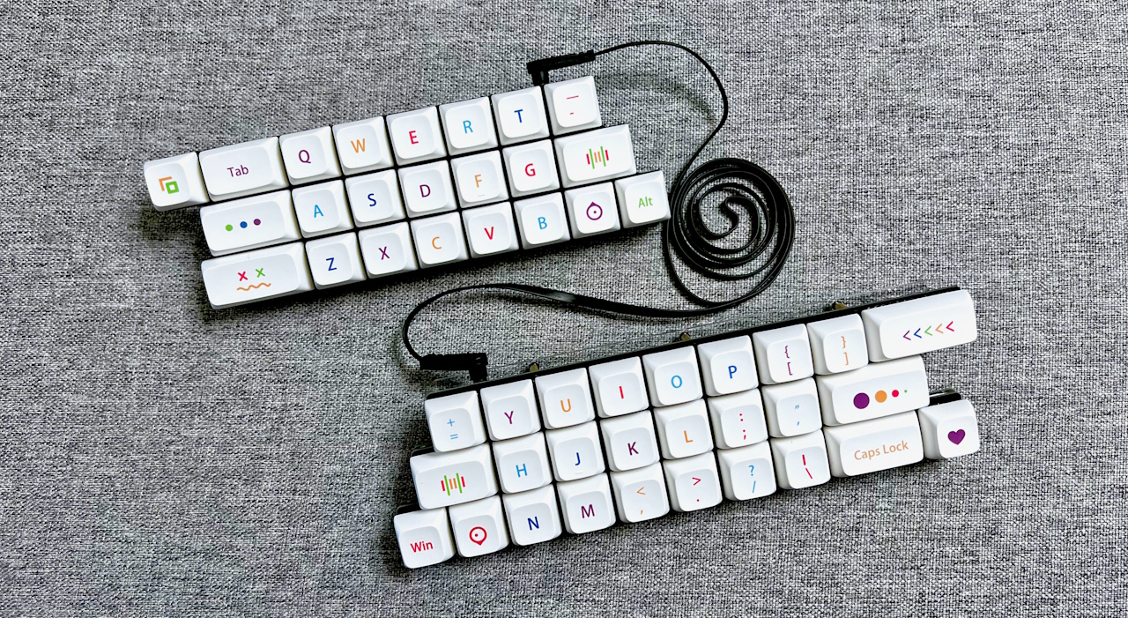
[picture p63: img/IMG_1758.jpg]
 
  
## ご用意いただくもの
- Type-C USBケーブル
- Windows/Mac（iPad、Androidでも使用できますが設定ができません）
## ファームウェアの書き込み
まずは動作ソフト（ファームウェア）をPop'n Topに書き込みます。  
Google ChromeかMicrosoft Edgeでこちらにアクセスし、Flashをクリックします。

- https://remap-keys.app/catalog/HJaX1fzuC9SmEQEK3czS/firmware

> [!NOTE]
> USBを接続する側でファームウェアを選んで、両手のキーボードに同じファームウェアを書き込んでください。
  
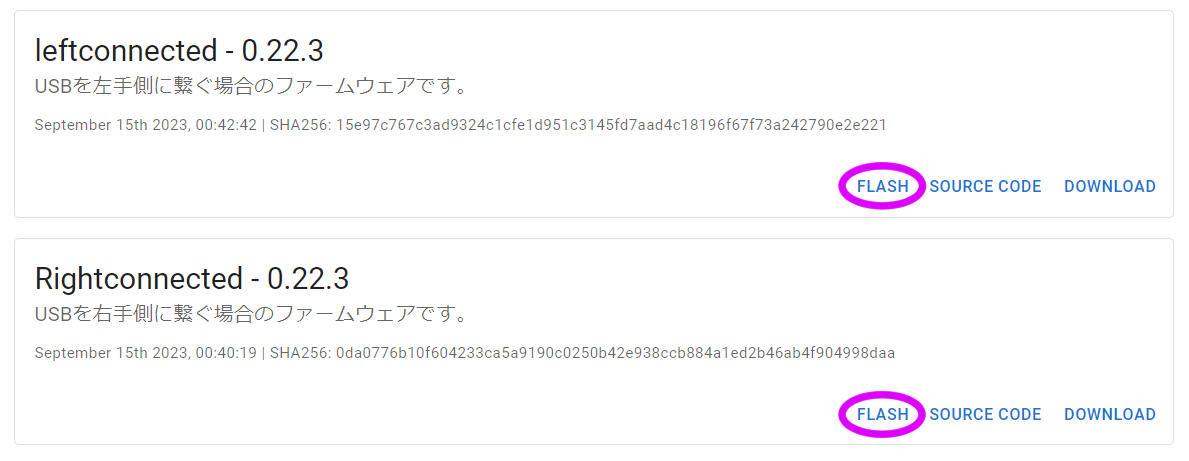
[picture p64: img/firmware1.png]
   
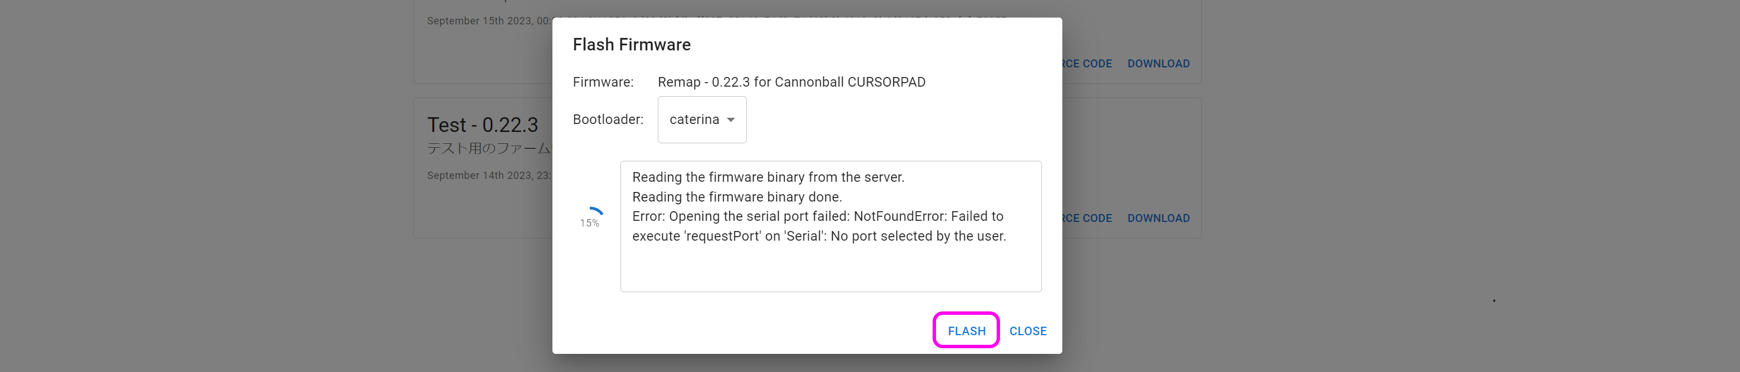
[picture p65: img/firmware2.png]
   
  
キット裏面のリセットスイッチを2回素早く押すと新しく項目が出てきます。
  
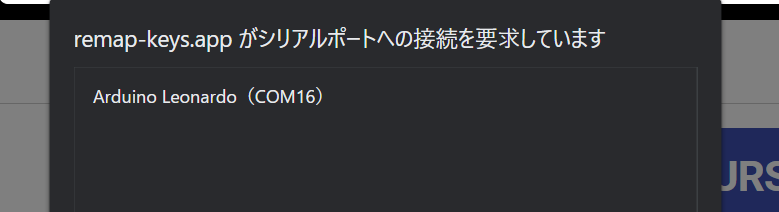
[picture p66: img/firmware3.png]
  
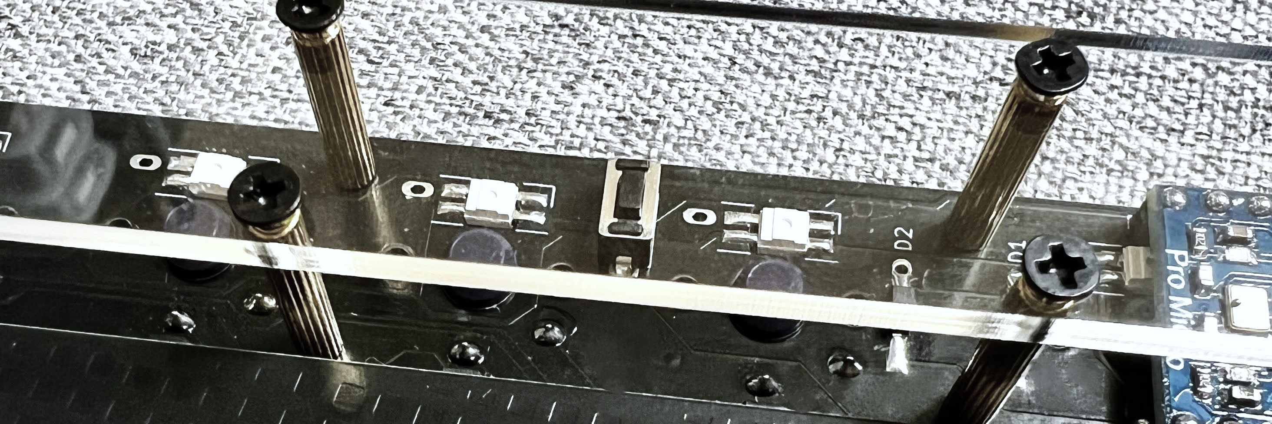
[picture p67: img/ura.jpg]
   

選択して接続を押すと書き込みが始まります。

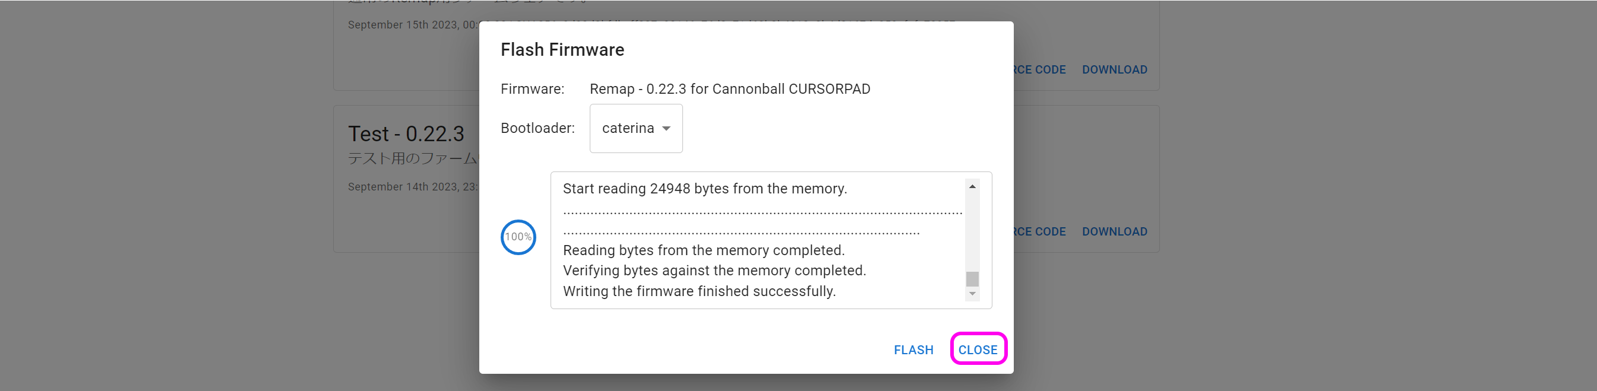
[picture p68: img/firmware4.png]
 
CLOSEを押してファームウェアの書き込みは完了です。

## キーのカスタマイズ
Google Chrome（Microsoft Edge）でこちらにアクセスしてください。
- Remap https://remap-keys.app

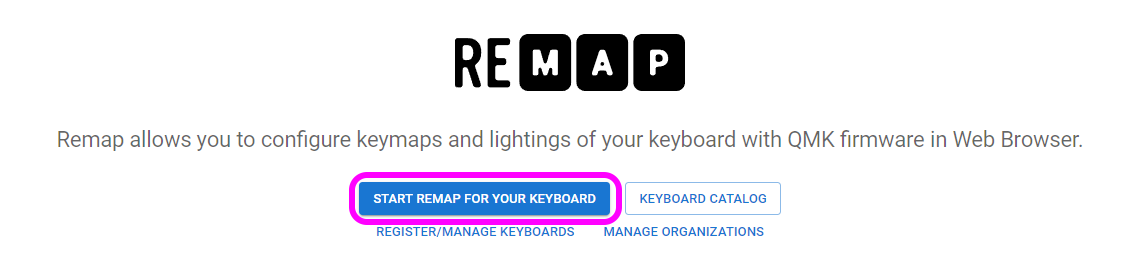
[picture p69: img/_remap1.png]
  
左を選んで進んでいくとダイアログが出てキーボードを選択できます。  
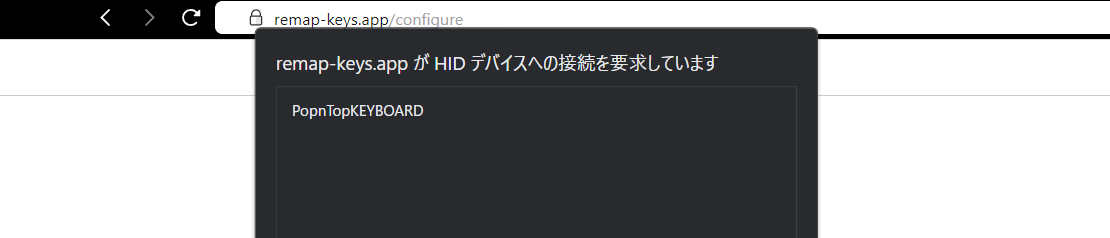
[picture p70: img/_remap2.png]
  
選択して接続してください。
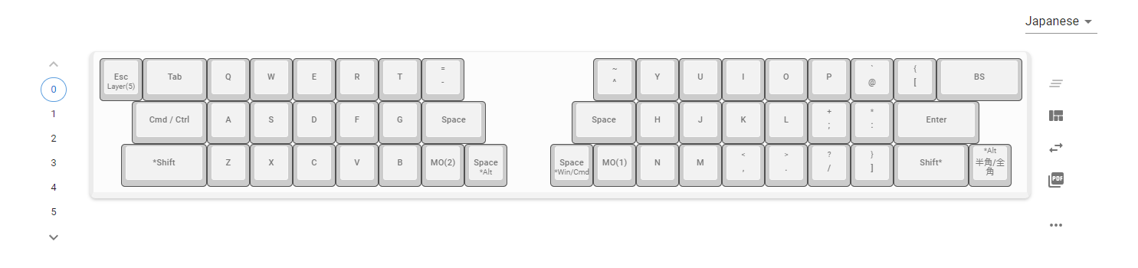
[picture p71: img/_remap3.png]
  
※販売時期により付属するキーキャップと設定が一致していないことがあります。

### USBの接続側を選ぶ
まずはレイアウトオプションでUSBの接続側を選んでください。  
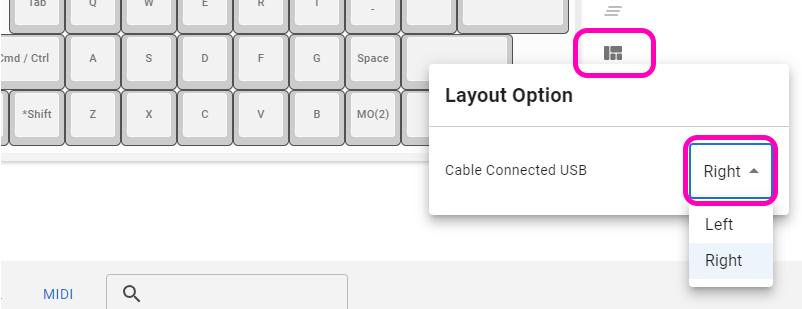
[picture p72: img/_remaplayout.png]
  

### キーマップの保存と復元
⇔アイコンで作ったキーマップを保存することができます。  
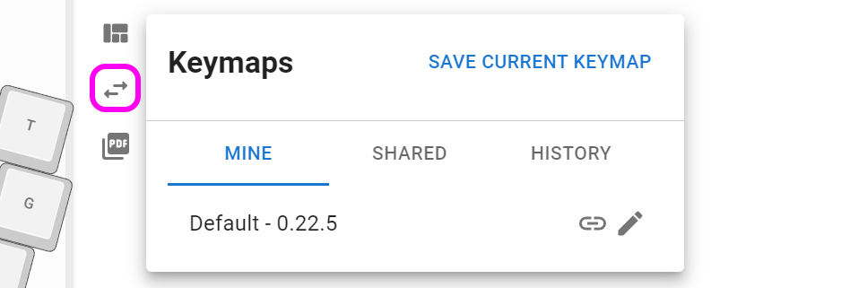
[picture p73: img/_remapkey.png]
  
作ったキーマップを共有することもできるので是非お試しください。

### キーを設定する
下のキー一覧からドラッグアンドドロップし、変更が終わったら右上のflashボタンを押すと反映されます。  
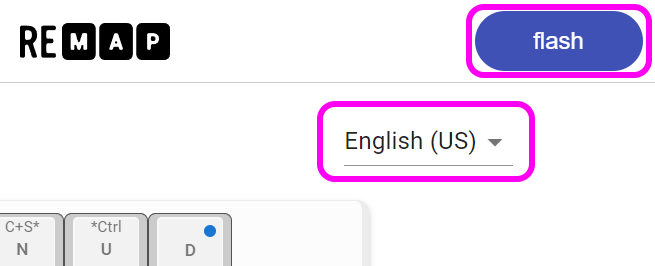
[picture p74: img/_remapflash.png]
  
また、USキーボードとJISキーボードはFlashの下のプルダウンから変更できます。OSの設定に合わせてください。

### 修飾キーとの組み合わせを設定する
キーボードのキーをクリックすると設定画面になります。
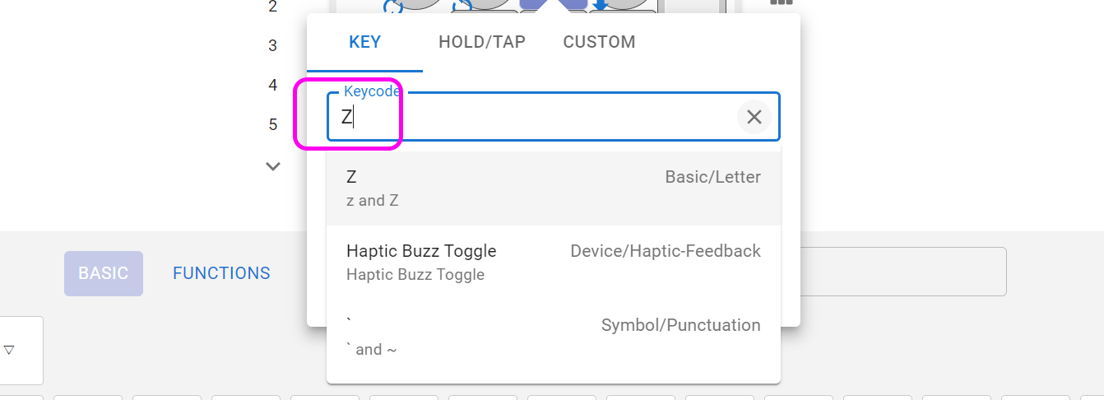
[picture p75: img/_remapmod1.png]
  
修飾キーと同時押ししたいキーを検索し、同時押ししたい修飾キーにチェックを入れます。
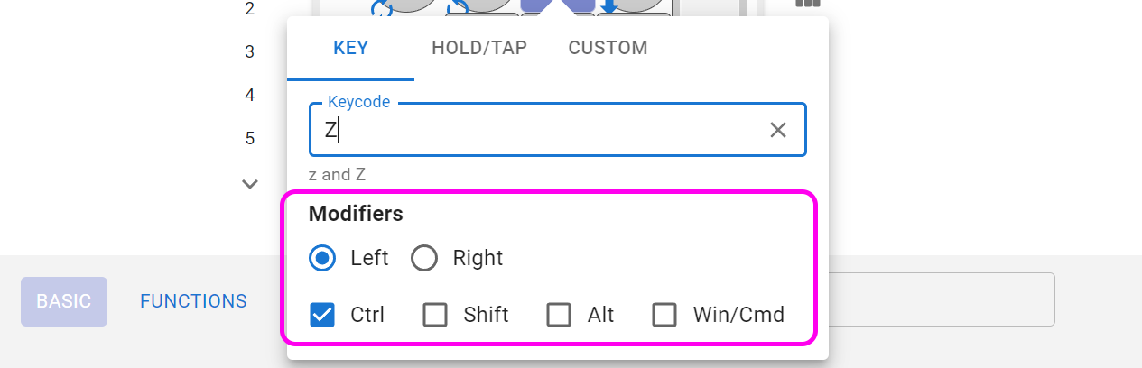
[picture p76: img/_remapmod2.png]
  

Hold-Tapもここから設定できます。

### 特殊なキーを設定する
FUNCTIONSタブのVIA USER KEYにあらかじめ用意されたショートカットキーがあります。
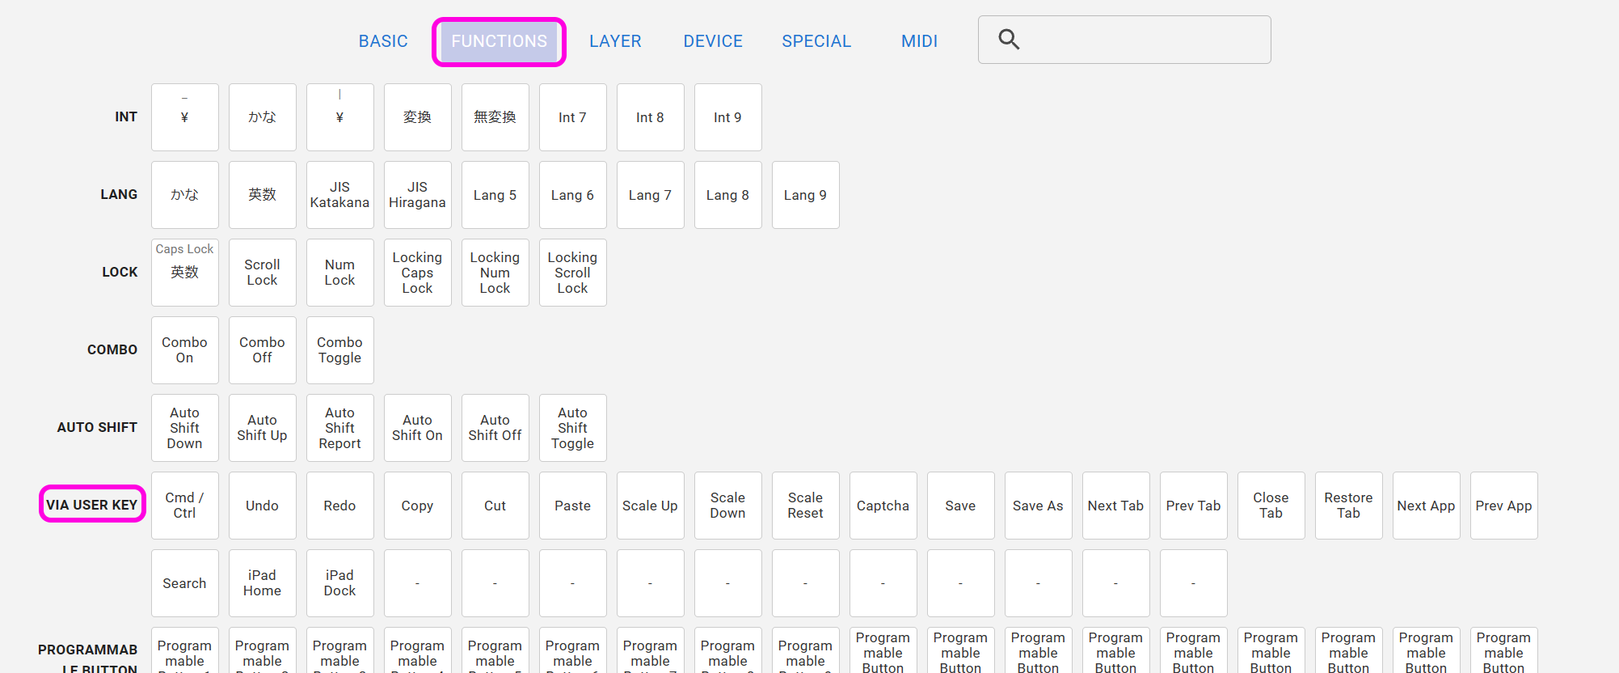
[picture p77: img/_remapshortcuts.png]
  

## その他
### キーキャップの引き抜き方
スイッチはキーキャップ側から見て下部の2点ではんだ付けされています。上部を持ち上げるように手前に引っ張ると金具が曲がり隙間が出来てしまうことがあります。
キーキャップ引き抜き用の工具を使い側面を掴み垂直に引き抜く事を意識すると抜きやすいです。
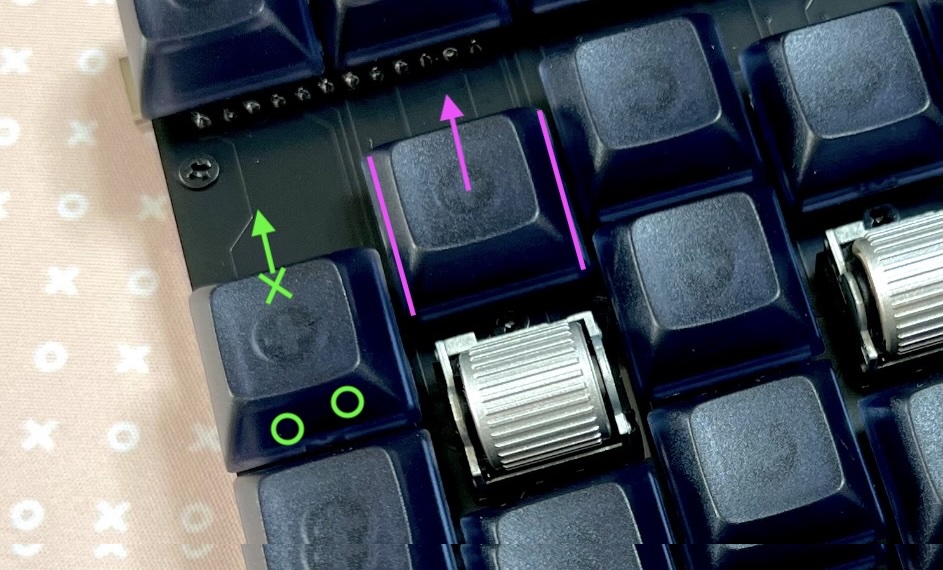
[picture p78: img/pull.jpg]
  

### 液晶タブレットに乗せる
1番上の行を引っ掛ける事で液タブに乗せる事ができます。  
  
ゴム足を外して両面テープで固定すると安定します。  
跡が残るといけないので画面には保護フィルムを貼ってください。  


### ファームウェアのフォルダ  
https://github.com/Taro-Hayashi/qmk_firmware/tree/tarohayashi/keyboards/tarohayashi/popntop

### 販売サイト
- 遊舎工房: https://shop.yushakobo.jp/collections/keyboard/products/2796   
- BOOTH: https://tarohayashi.booth.pm/items/3154435
