Taro-Hayashi/Pop-n-Top/howtochosekeycaps.md

# キーキャップの選び方
スイッチに対応したキーキャップをご使用ください。  
choc V1は[専用キーキャップ](https://shop.yushakobo.jp/collections/keycaps/For-Choc-v1)が販売されていて、choc V2, Lofreeは[CherryMX互換](https://shop.yushakobo.jp/collections/keycaps/cherry-mx-%E4%BA%92%E6%8F%9B-%E3%82%AD%E3%83%BC%E3%82%AD%E3%83%A3%E3%83%83%E3%83%97)のキーキャップが使えます。

キーキャップの長さに種類があります。  

|長さ|個数|
|-|-|
|1U|42個|
|1.5U|3個|
|1.75U|2個|
|2U|3個|  

Uというのは正方形を1とした時の横幅です。
choc V1を使う場合1.75Uのキーキャップは1.5U以下を使ってください。

ブラウザの機能で戻ってください。
